franciscoarcos19/Proyecto_Protesis/README.md

# Proyecto_Protesis
Desarrollo de una prótesis para personas con amputación transhumeral o desarticulación de codo

Este es un proyecto financido por la Universidad Santiago de Cali, en el cual participan profesores y estudiantes de la misma Universidad
