franciscoarcos19/Proyecto_Protesis/Diseño_Mecánico/readme

En este directorio se encuentran los archivos STL de cada parte diseñada de la prótesis
