franciscoarcos19/Proyecto_Protesis/Control_Motores/readme

En este directorio se encuentra información y códigos realizados para el control de motores brushless
