franciscoarcos19/Proyecto_Protesis/Codigos_de_adquisicion/readme

En este directorio se encuentran los códigos con los cuales se adquirieon las señales, se trabajo con Arduino inicialmente incluido RTOS, pero finalmente el DataSet se construyo con una Beaglebone
