franciscoarcos19/Proyecto_Protesis/Compras/Solicitud_compras4/readme

Solicitud de compras de drivers de potencia para los motores BLDC y el motor del gripper
