franciscoarcos19/Proyecto_Protesis/Control_Motores/Control_de_Motores_BLDC/Informacion_JuanPabloAngulo_Canguro/link_videos.txt

Video 1:
https://www.youtube.com/watch?v=_aAwbQtJsLo&t=101s

Video 2:
https://www.youtube.com/watch?v=N1daKq9xIF4&t=0s

Video 3:
https://www.youtube.com/watch?v=YvfU8nAqAI8&t=0s

Video 4:
https://www.youtube.com/watch?v=TnECJG2mN-E&t=0s

Video 5:
https://www.youtube.com/watch?v=MKNkZOja7-s&t=0s

Video que recomienda acerca de motores eléctricos:
https://www.youtube.com/watch?v=I2_-etus0KQ&t=0s
