franciscoarcos19/Proyecto_Protesis/RealTime_MachineLearning/readme

DIrectorio donde se encuentran los archivos relacionados con la implementación de machine learning en tiempo real
