franciscoarcos19/Proyecto_Protesis/Articulo_Q2_2021/readme

Directorio en el cual se cargará la información para construir el artículo Q2 del 2021
