franciscoarcos19/Proyecto_Protesis/PagoEstudiantes/readme

Directorio en el cual se encuentra información relacionada con el pago de los estudiantes involucrados en el proyecto
