franciscoarcos19/Proyecto_Protesis/Compras/readme

En este directorio se encuentran las solicitudes de compra realizadas
