franciscoarcos19/Proyecto_Protesis/Machine_Learning/readme

En este directorio se encuentran los códigos para realizar la extracción de características, posteriormente se incluirán los códigos para realizar la clasificación
