franciscoarcos19/Proyecto_Protesis/DATA_SET_Myoelectric_Signals/readme

Directorio en el cual se encuentran las señales mioeléctricas de una persona con desarticulación de codo
