franciscoarcos19/Proyecto_Protesis/RealTime_MachineLearning/Solucion1/readme

En este directorio se encuentran los archivos para hacer la adquisición de datos y predicción del movimiento en tiempo real
