franciscoarcos19/Proyecto_Protesis/Codigos_de_adquisicion/Beaglebone/readme

Directorio en el que se encuentran los códigos para leer las señales con la Beaglebone
