franciscoarcos19/Proyecto_Protesis/DATA_SET_Myoelectric_Signals/Movimientos_Contraccion_Maxima/readme

En este directorio se encuentran los movimientos de contracción máxima
