franciscoarcos19/Proyecto_Protesis/Machine_Learning/Extraccion_Caracteristicas/Codes_PAC_v2/readme

Directorio que contiene los mismos archivos de la carpeta Codes_Pac, pero en este caso se guarda el clasificador y se utiliza posteriormente con datos singulares
