franciscoarcos19/Proyecto_Protesis/Machine_Learning/Extraccion_Caracteristicas/Codigos_Milton_Mejorados/readme

Actualización de los códigos realizados por el profe Milton, ya incluyen las características de William, las mias, y las de frecuencia
