franciscoarcos19/Proyecto_Protesis/Machine_Learning/Extraccion_Caracteristicas/Codes_Milton_William_F/readme

En este directorio se encuentran codigos combinados basados en las características de William, la automatizacion de Milton y mis códigos de visualización
