franciscoarcos19/Proyecto_Protesis/Machine_Learning/Extraccion_Caracteristicas/Caracteristicas_V2/readme

Directorio en el cual se encuentran las características extraidas, en el proceso anterior hubo un error, por esa razón se generó este directorio
