franciscoarcos19/Proyecto_Protesis/DATA_SET_Myoelectric_Signals/Data Set – Myoelectric Signals.pptx

## Data Set – Myoelectric Signals

## M1 – Flexión de Codo, Set 1

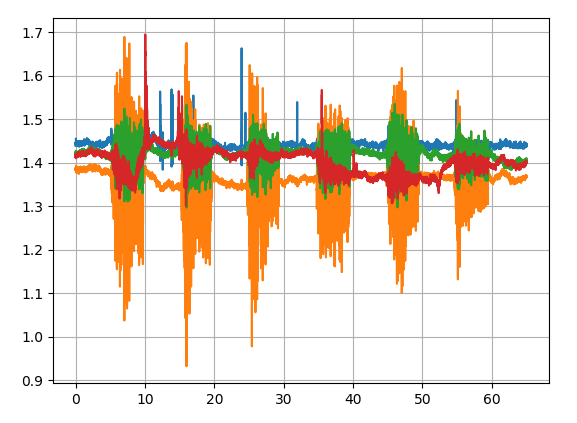
[picture p1: figure]

## M1 – Flexión de Codo, Set 2

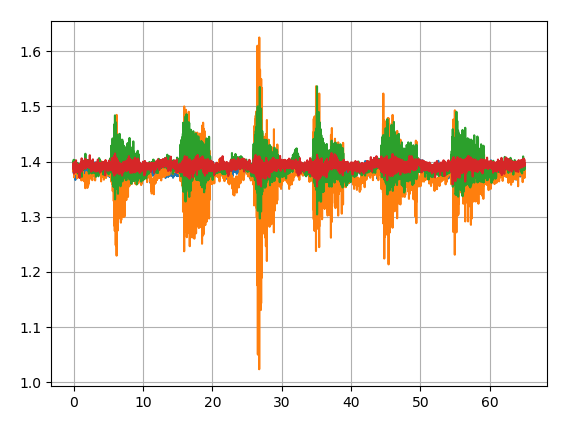
[picture p2: figure]

## M1 – Flexión de Codo, Set 3

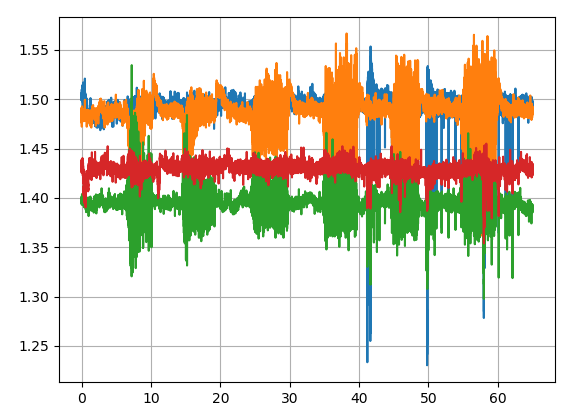
[picture p3: figure]

## M1 – Flexión de Codo, Set 4

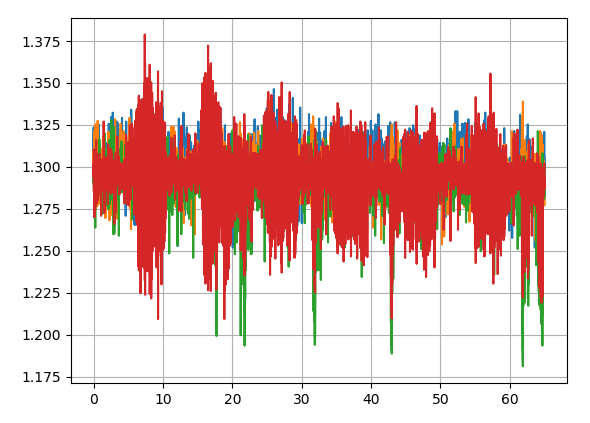
[picture p4: figure]

## M1 – Flexión de Codo, Set 5

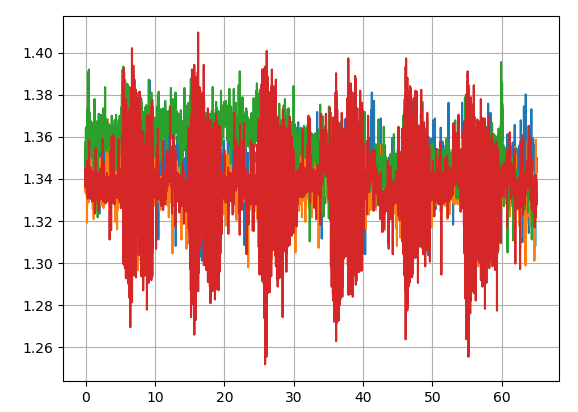
[picture p5: figure]

## M1 – Flexión de Codo, Set 6

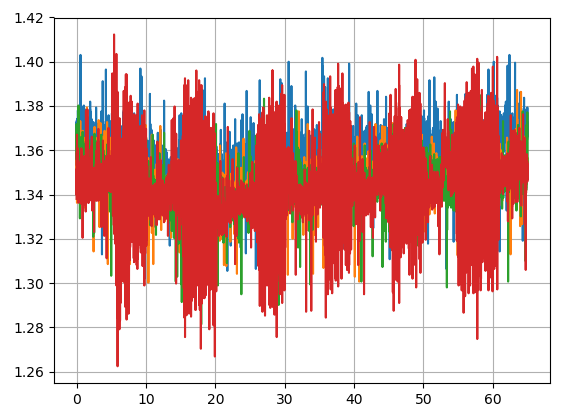
[picture p6: figure]
