franciscoarcos19/Proyecto_Protesis/Compras/Solicitud_Compras5/cotizacion_ferplast.docx

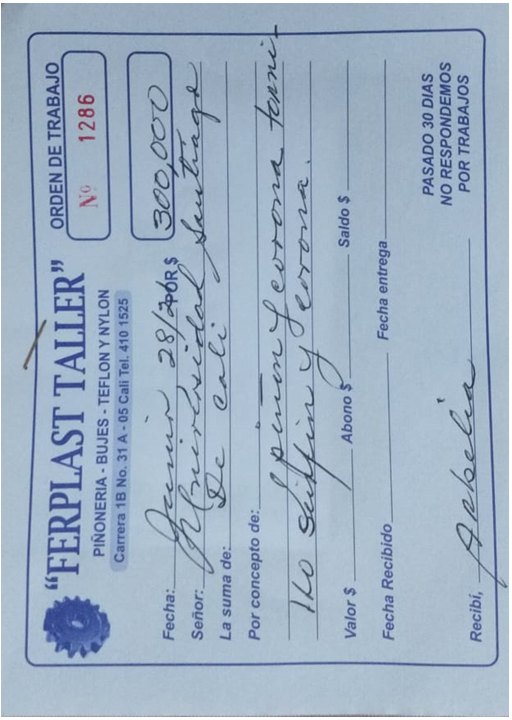
[picture p7: figure]
