franciscoarcos19/Proyecto_Protesis/Machine_Learning/Extraccion_Caracteristicas/senales_caracteristicas.pptx

Se usaron 4 sensores como el que se muestra en la figura, ubicados en el miembro residual de una persona con desarticulación de codo.
- S1-Deltoides
- S2-Biceps
- S3-Triceps
- S4-Tendón bíceps braquial
Se capturaron las señales emitidas por los sensores a una frecuencia de 1Khz cuando la persona realizaba diferentes movimientos. Los movimientos son:
- M1-Flexión de codo
- M2-Extensión de codo
- M3-Apertura de mano
- M4-Cierre de mano
- M5-Pronación de mano
- M6-Supinación de mano
- M7-Reposo

La ventana de datos para hacer la extracción de características es 100 datos, lo cual corresponde a 0.1 seg de señal

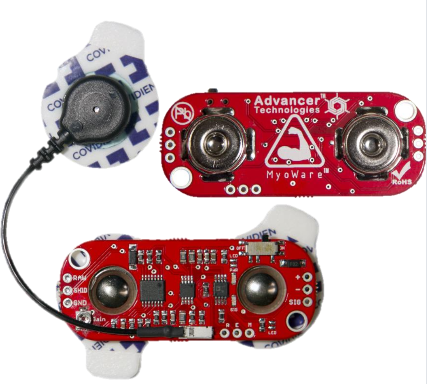
[picture p8: figure]

## GRÁFICAS PARA M1

## Slide 3

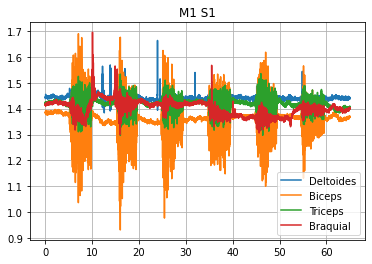
[picture p9: figure]
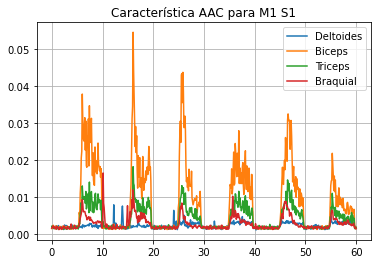
[picture p10: figure]
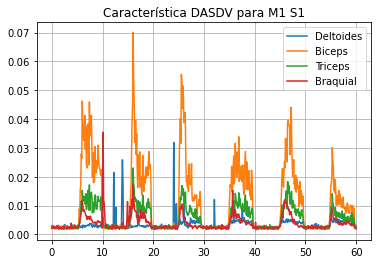
[picture p11: figure]
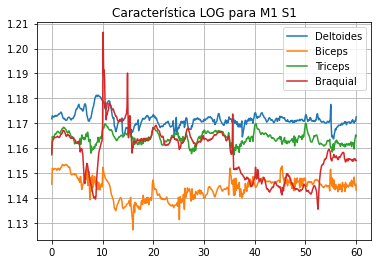
[picture p12: figure]
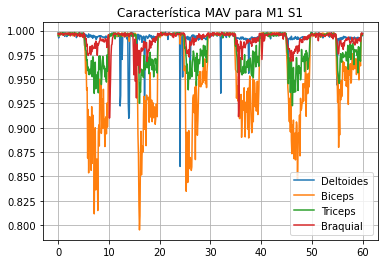
[picture p13: figure]
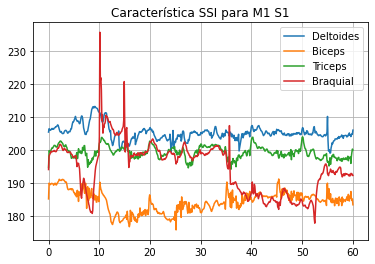
[picture p14: figure]
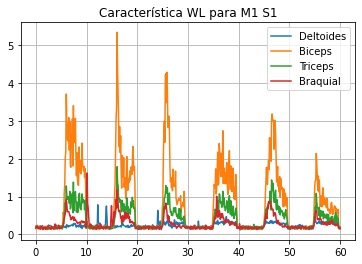
[picture p15: figure]
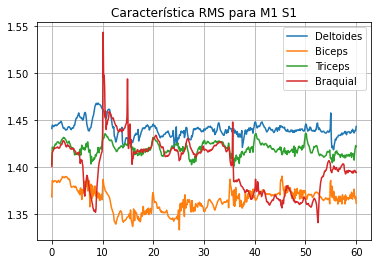
[picture p16: figure]

## Slide 4

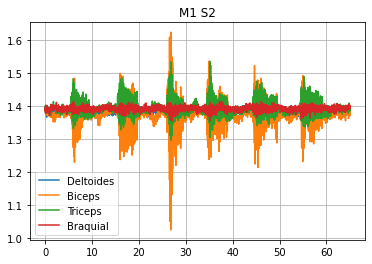
[picture p17: figure]
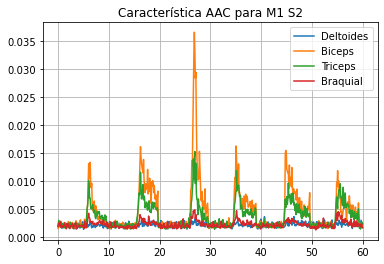
[picture p18: figure]
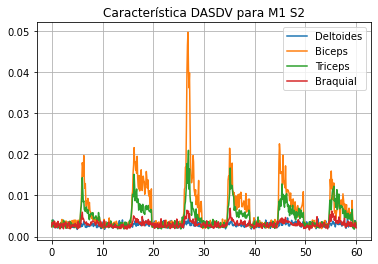
[picture p19: figure]
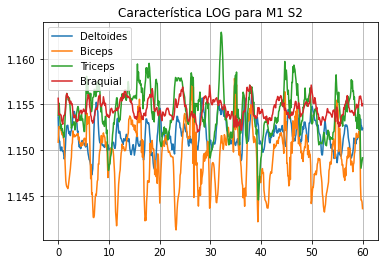
[picture p20: figure]
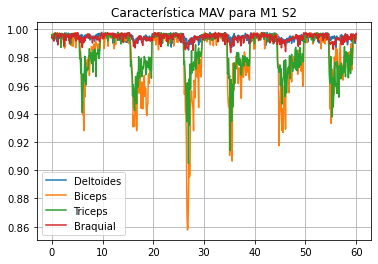
[picture p21: figure]
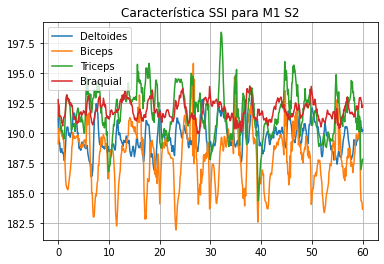
[picture p22: figure]
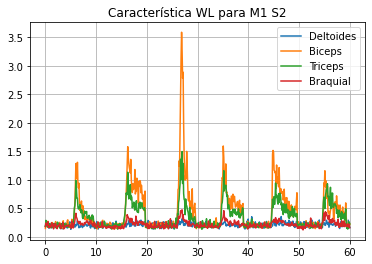
[picture p23: figure]
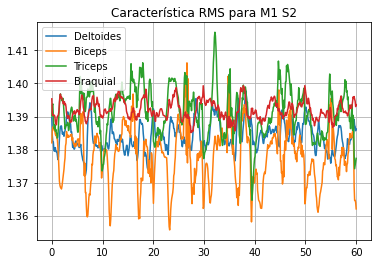
[picture p24: figure]

## Slide 5

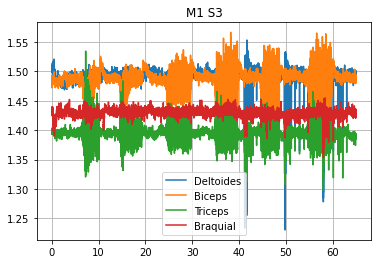
[picture p25: figure]
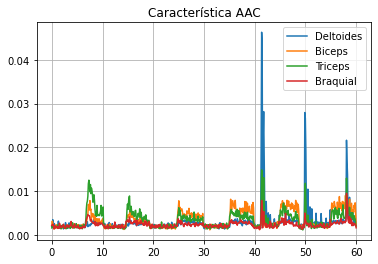
[picture p26: figure]
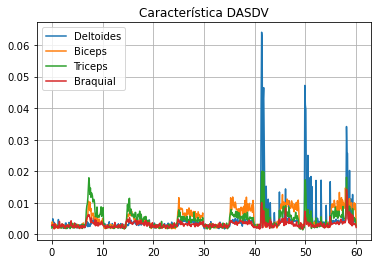
[picture p27: figure]
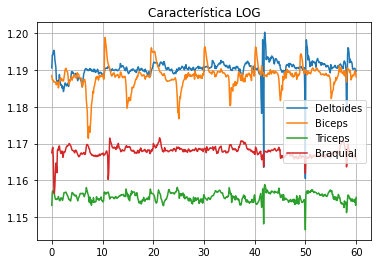
[picture p28: figure]
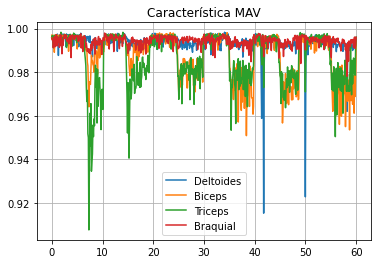
[picture p29: figure]
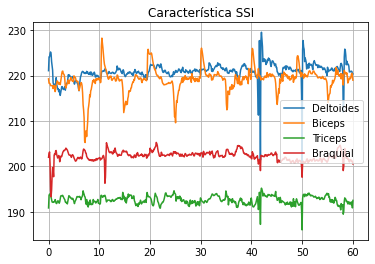
[picture p30: figure]
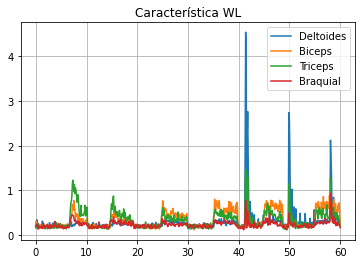
[picture p31: figure]
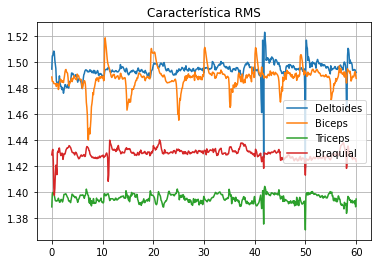
[picture p32: figure]

## Slide 6

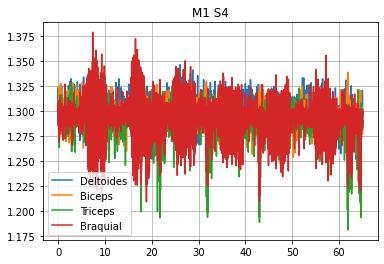
[picture p33: figure]
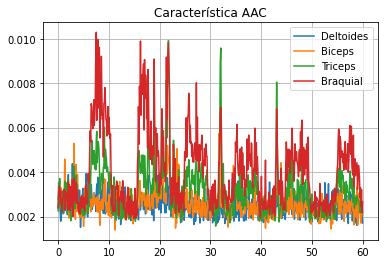
[picture p34: figure]
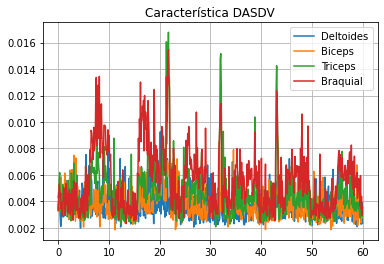
[picture p35: figure]
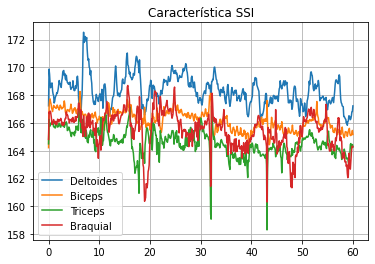
[picture p36: figure]
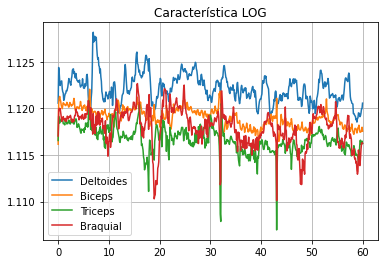
[picture p37: figure]
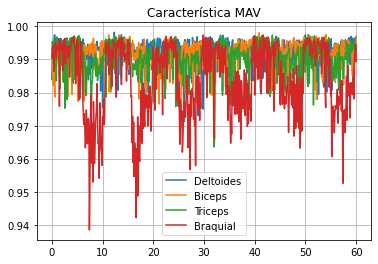
[picture p38: figure]
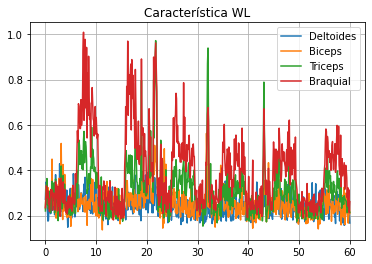
[picture p39: figure]
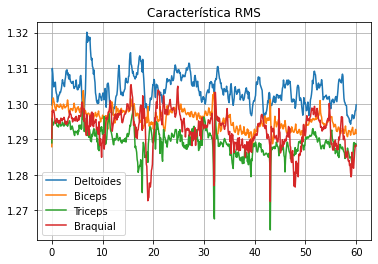
[picture p40: figure]

## Slide 7

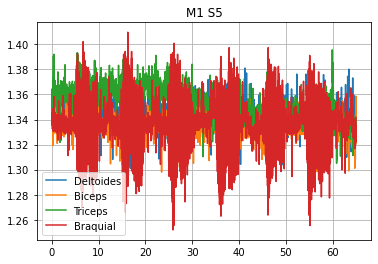
[picture p41: figure]
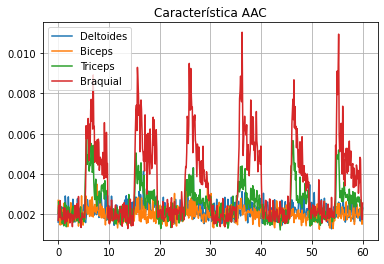
[picture p42: figure]
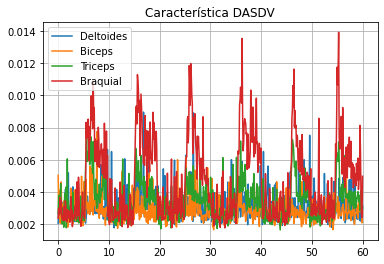
[picture p43: figure]
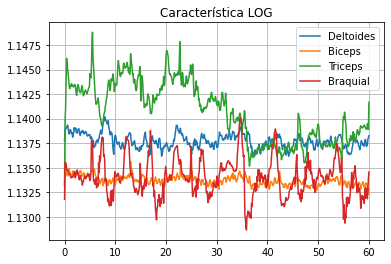
[picture p44: figure]
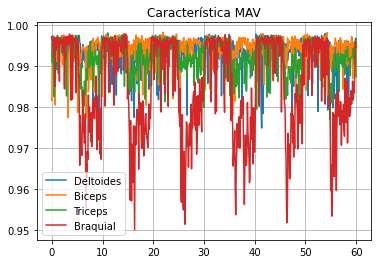
[picture p45: figure]
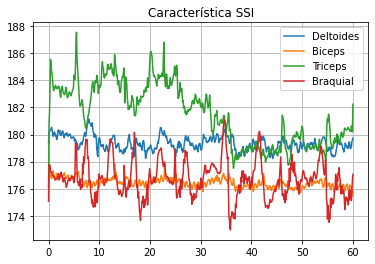
[picture p46: figure]
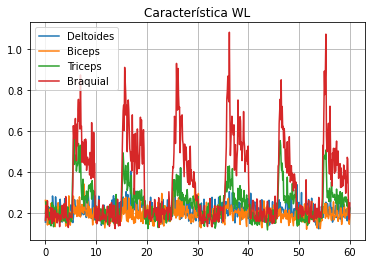
[picture p47: figure]
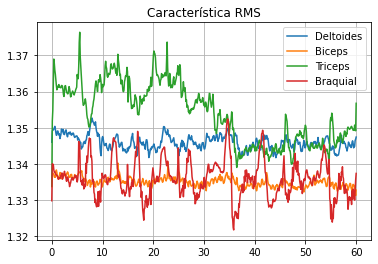
[picture p48: figure]

## Slide 8

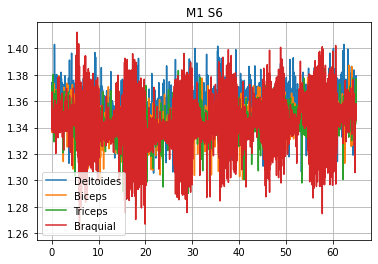
[picture p49: figure]
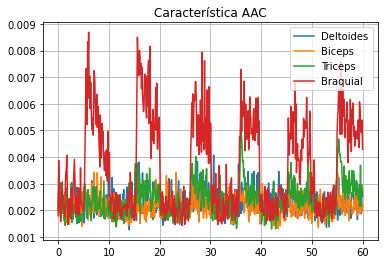
[picture p50: figure]
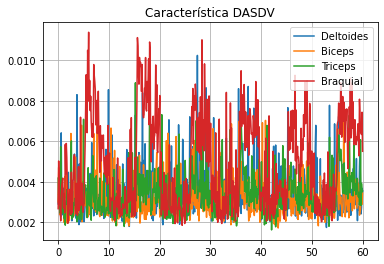
[picture p51: figure]
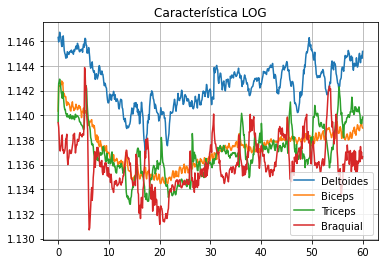
[picture p52: figure]
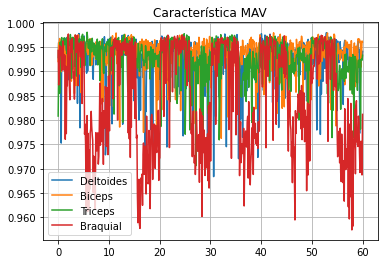
[picture p53: figure]
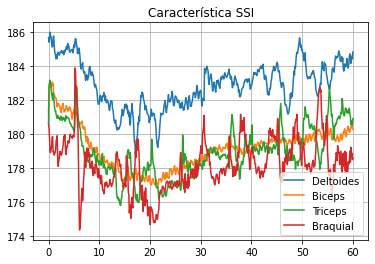
[picture p54: figure]
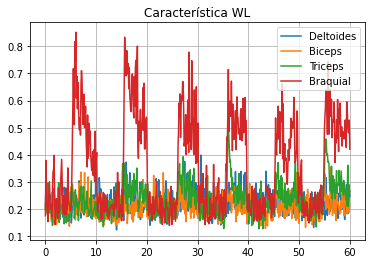
[picture p55: figure]
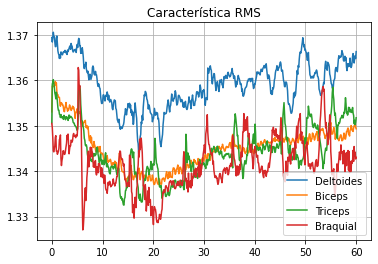
[picture p56: figure]

## GRÁFICAS PARA M2

## Slide 10

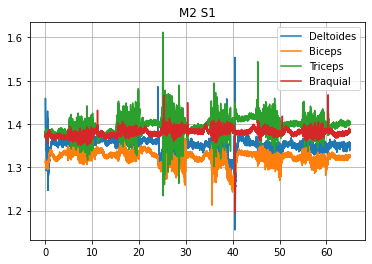
[picture p57: figure]
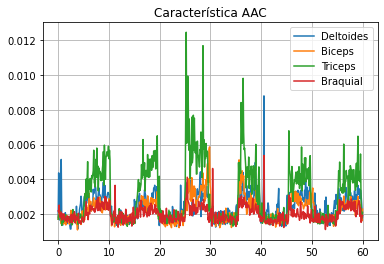
[picture p58: figure]
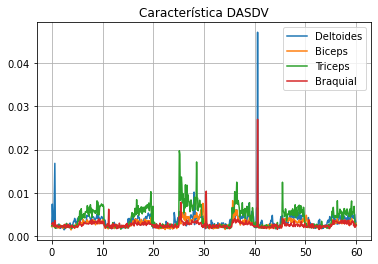
[picture p59: figure]
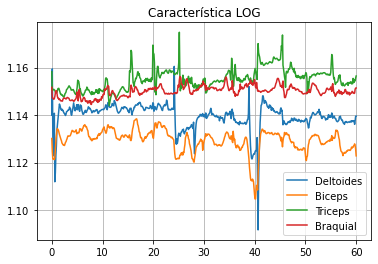
[picture p60: figure]
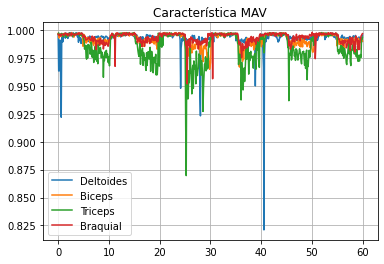
[picture p61: figure]
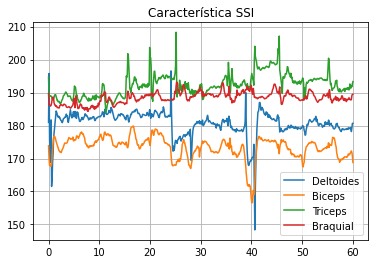
[picture p62: figure]
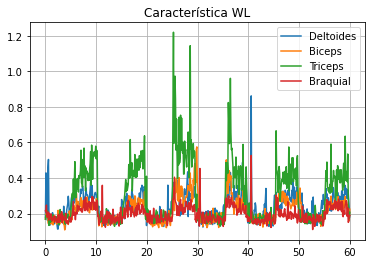
[picture p63: figure]
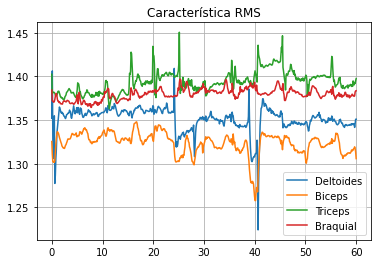
[picture p64: figure]

## Slide 11

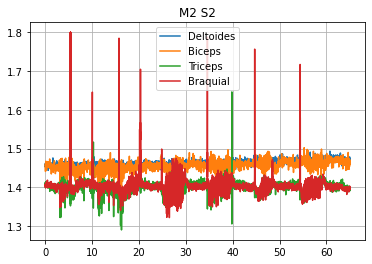
[picture p65: figure]
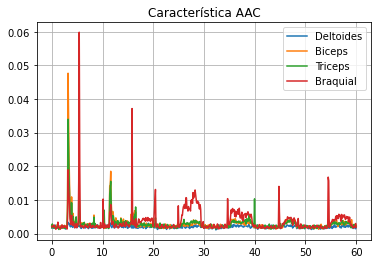
[picture p66: figure]
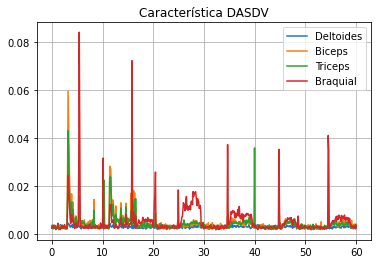
[picture p67: figure]
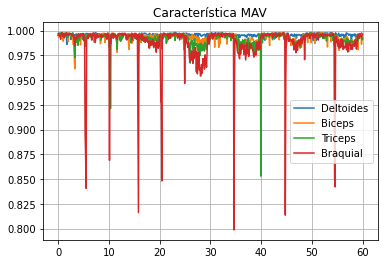
[picture p68: figure]
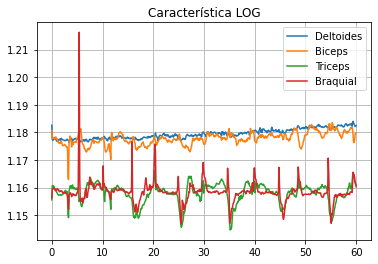
[picture p69: figure]
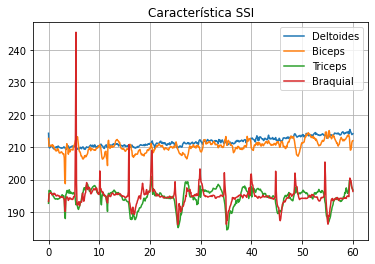
[picture p70: figure]
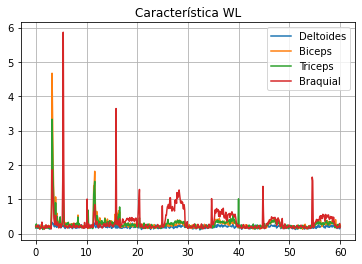
[picture p71: figure]
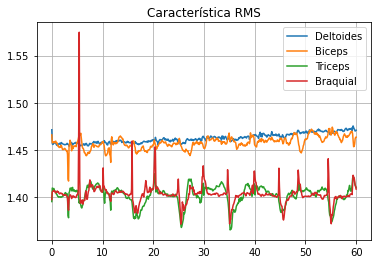
[picture p72: figure]

## Slide 12

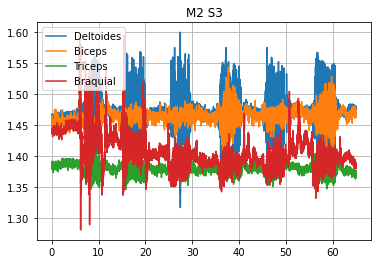
[picture p73: figure]
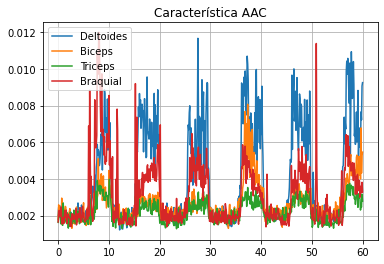
[picture p74: figure]
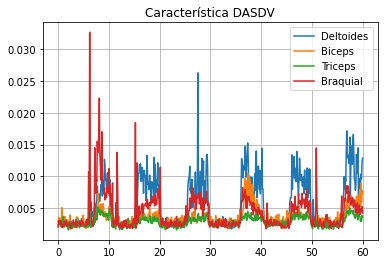
[picture p75: figure]
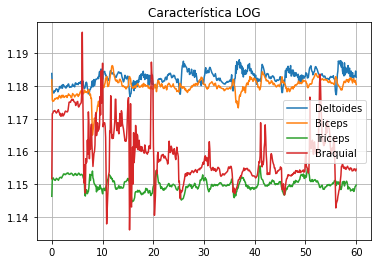
[picture p76: figure]
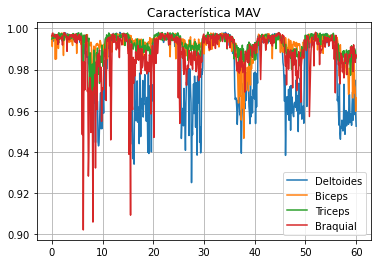
[picture p77: figure]
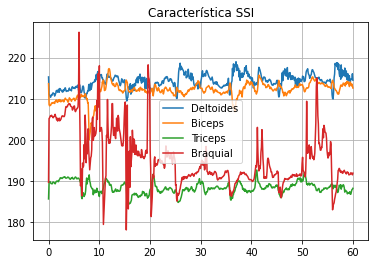
[picture p78: figure]
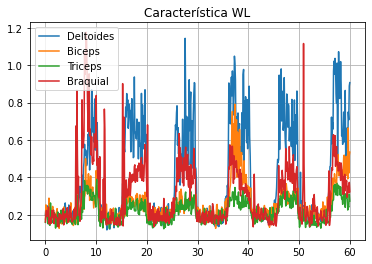
[picture p79: figure]
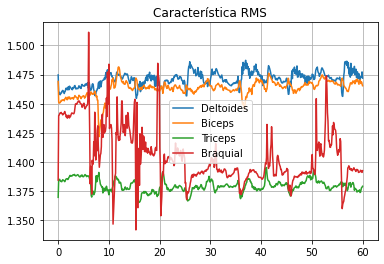
[picture p80: figure]

## Slide 13

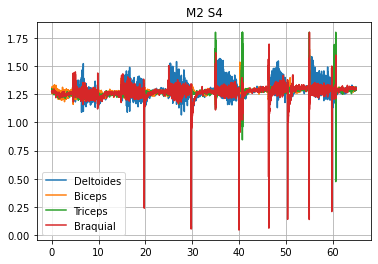
[picture p81: figure]
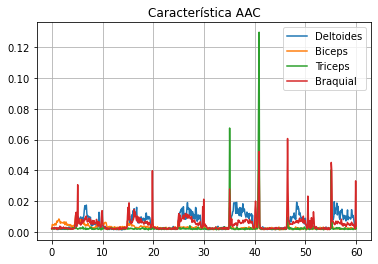
[picture p82: figure]
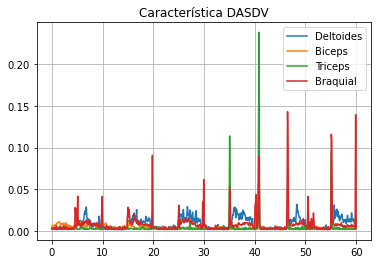
[picture p83: figure]
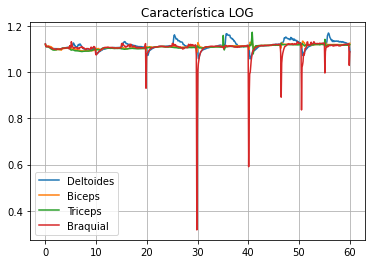
[picture p84: figure]
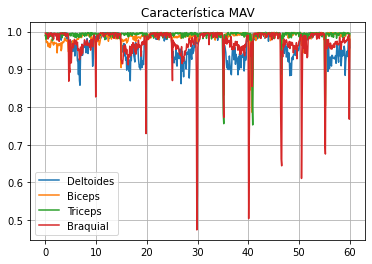
[picture p85: figure]
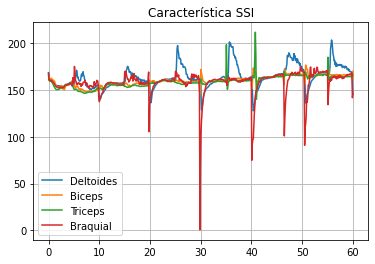
[picture p86: figure]
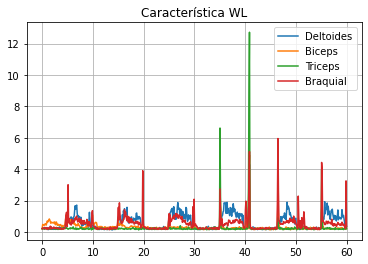
[picture p87: figure]
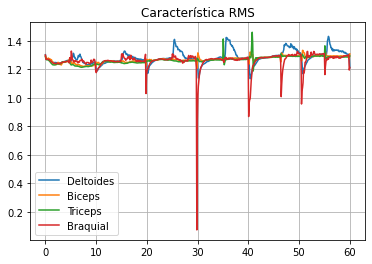
[picture p88: figure]

## Slide 14

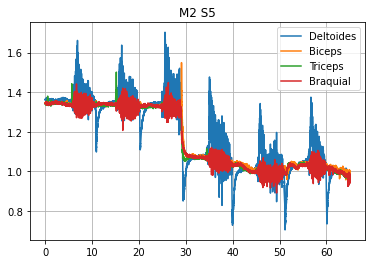
[picture p89: figure]
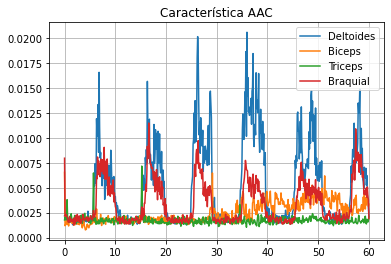
[picture p90: figure]
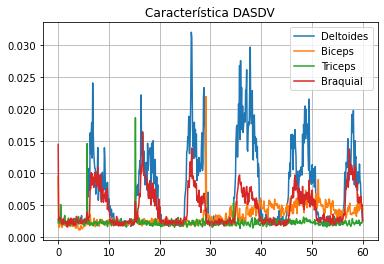
[picture p91: figure]
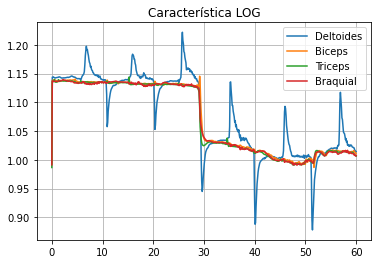
[picture p92: figure]
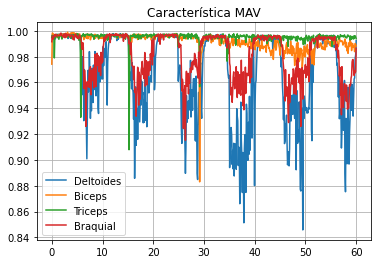
[picture p93: figure]
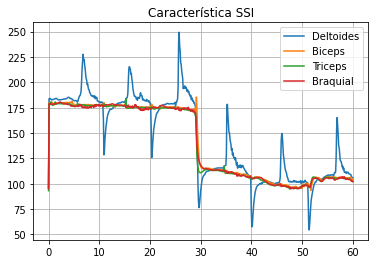
[picture p94: figure]
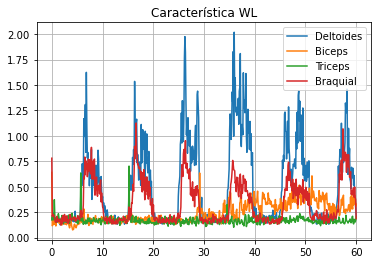
[picture p95: figure]
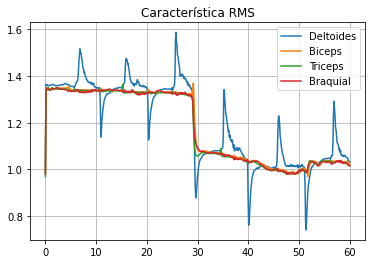
[picture p96: figure]

## Slide 15

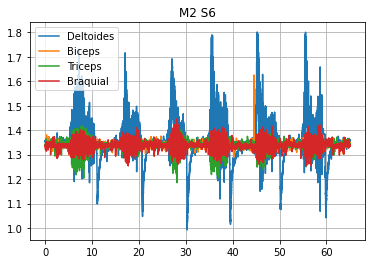
[picture p97: figure]
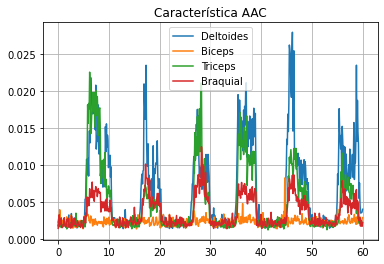
[picture p98: figure]
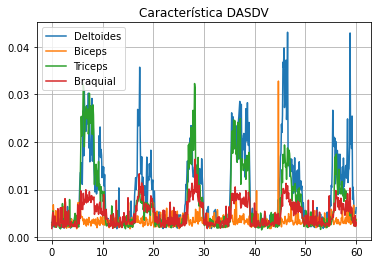
[picture p99: figure]
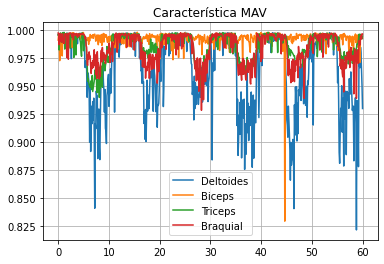
[picture p100: figure]
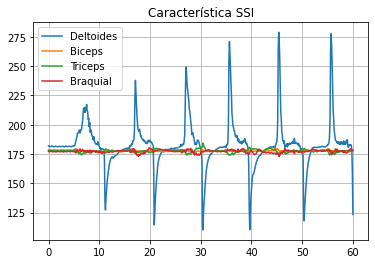
[picture p101: figure]
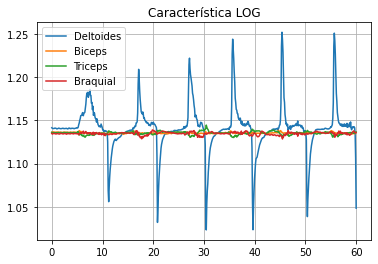
[picture p102: figure]
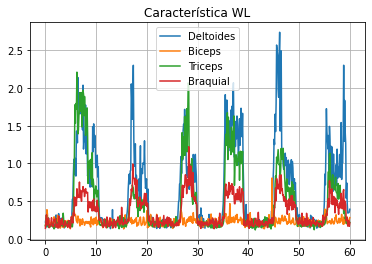
[picture p103: figure]
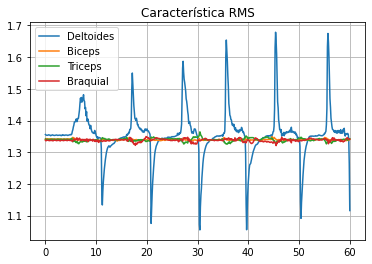
[picture p104: figure]

## Slide 16

## Slide 17
