franciscoarcos19/Proyecto_Protesis/informacion_general/acta_inicio.pdf

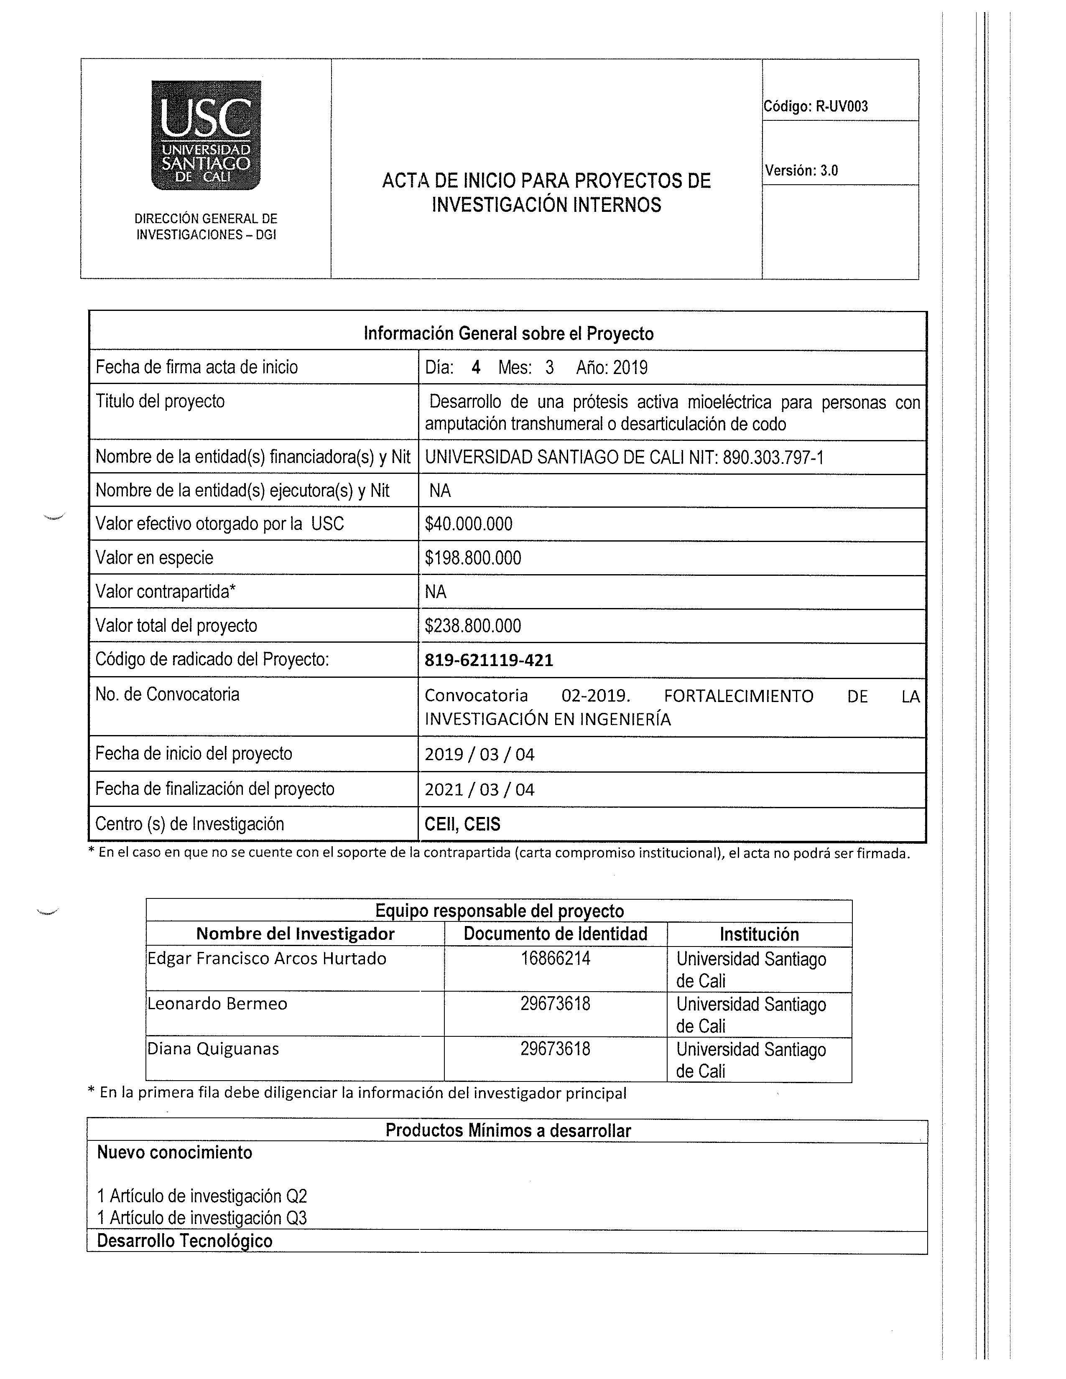
[picture p105: page 1]
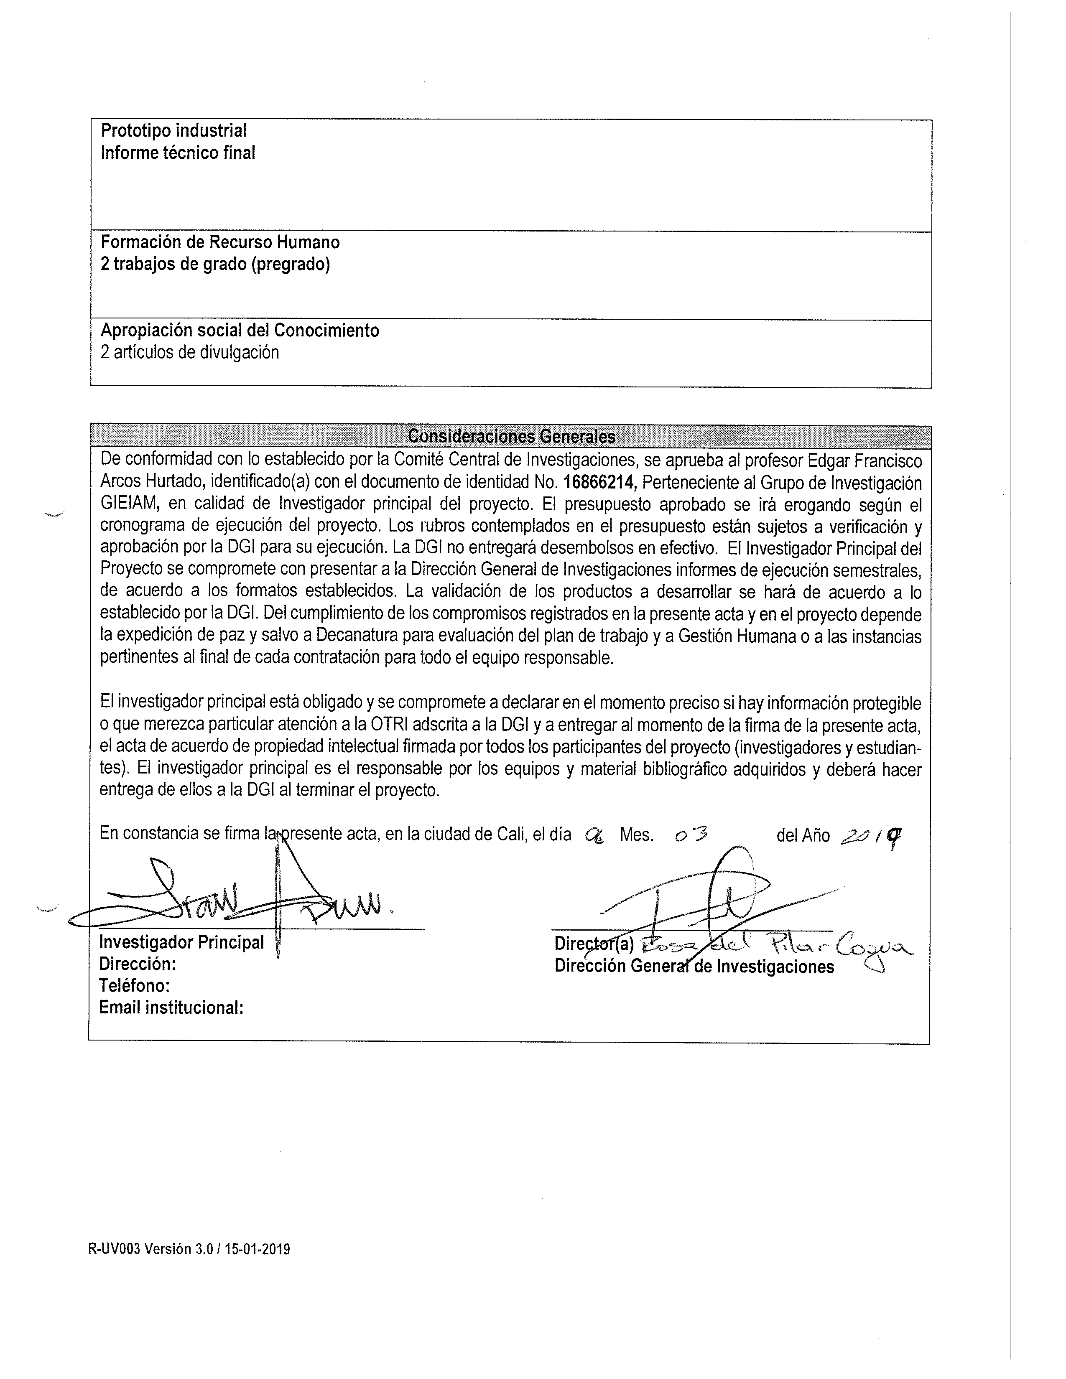
[picture p106: page 2]
