franciscoarcos19/Proyecto_Protesis/informacion_general/PRORROGA.pdf

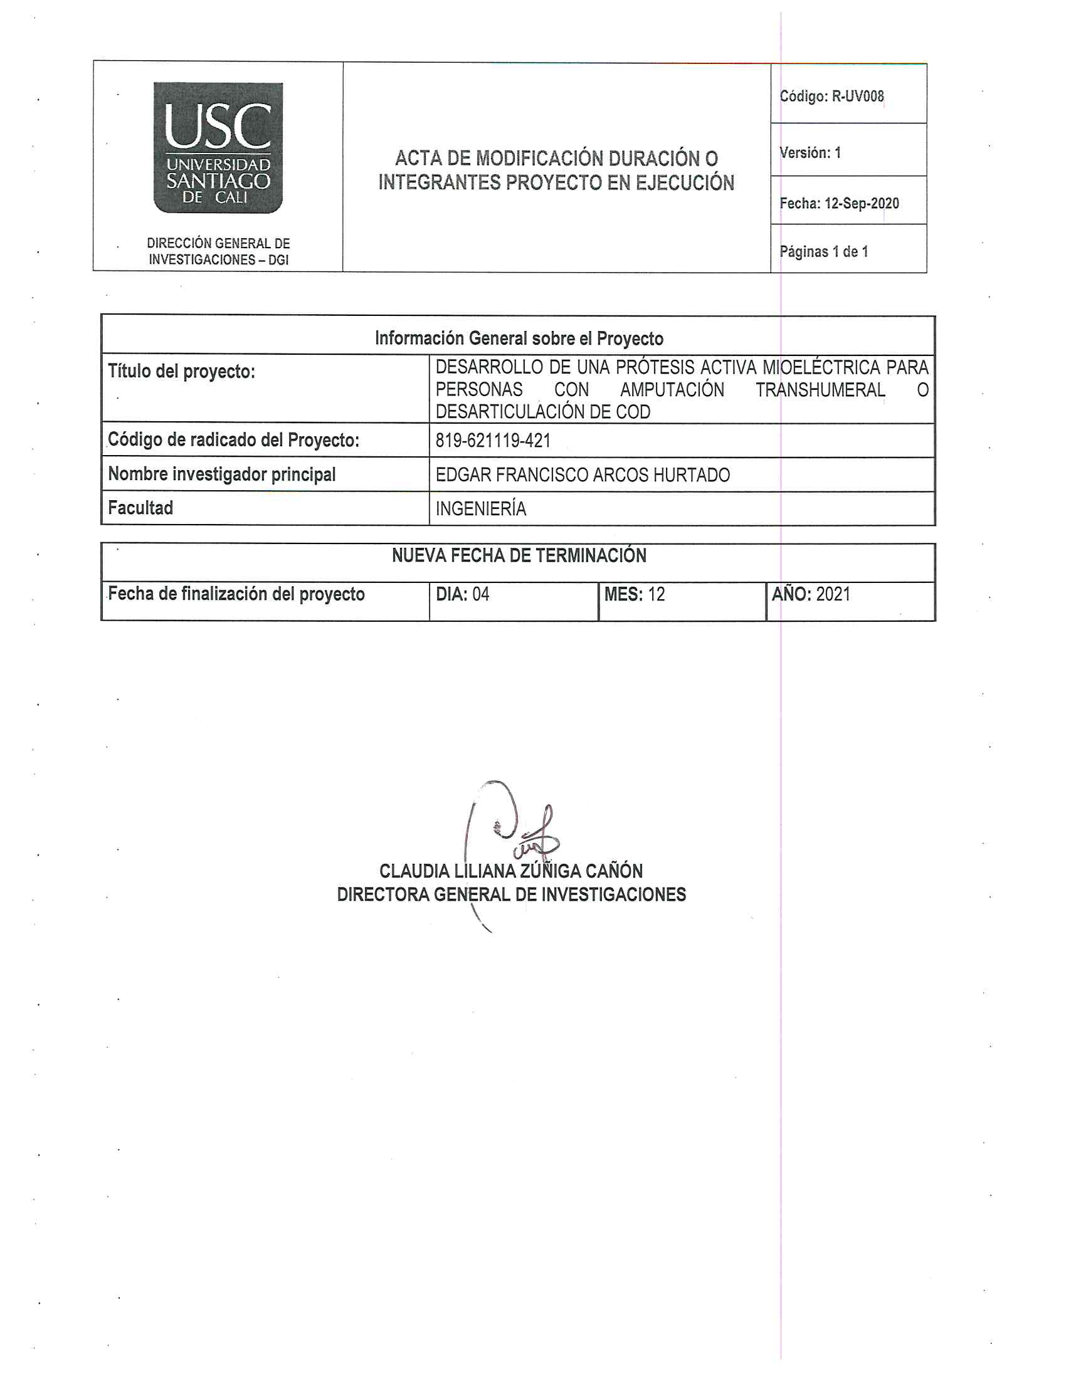
[picture p107: page 1]
