franciscoarcos19/Proyecto_Protesis/Compras/Solicitud_Compras5/Plano corona.pdf

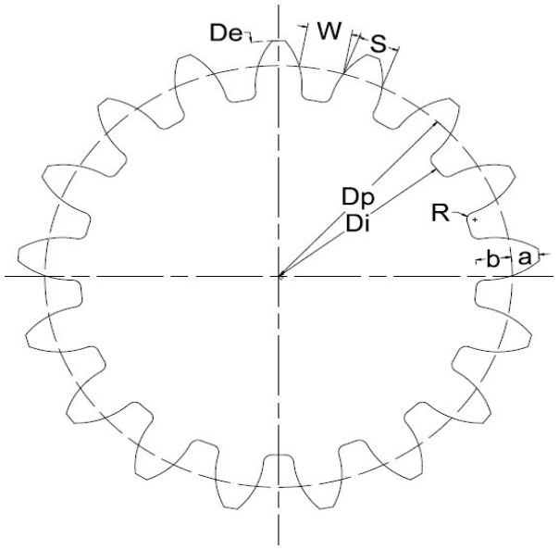
[picture p109: figure]

Parametro | Formula | Piñon | Corona
Dientes (Z) | | 8,0 | 17,0
Diametro exterior (De) | Dp+2*M | 10,0 | 19,0
Diametro primitivo (Dp o d) | Z*M | 8,0 | 17,0
Diametro interior (Di)
hueco del diente (W) | Pc*21/40 = π*M21/40 | 1,6 | 1,6
Espesor del diente (S) | Pc*19/40 | 1,5 | 1,5
radio de entalle (r) | Pc/12 = π*M/12 | 0,3 | 0,3
altura de cabeza (a) | M | 1,0 | 1,0
altura del pie del diente (b) | 1.25*M | 1,3 | 1,3
Dientes (Z)
Modulo (M) | De/z+2 | 1,0
Paso circular (Pc) o (P) | π*M o S+W | 3,1
Angulo de presion | | 20,0
Angulo entre dientes | | 45,0 | 21,2
distancia entre centro (DC) | (Dp+dp)/2 | 12,5

Plano corona

Juego de piñon - corona
