franciscoarcos19/Proyecto_Protesis/Machine_Learning/Extraccion_Caracteristicas/Codes_PAC/readme

En este directorio se encuentran los códigos para implementar la clasificación utilizando PAC y características de frecuencia nuevas
