franciscoarcos19/Proyecto_Protesis/Codigos_de_adquisicion/Beaglebone/Captura_4C_1Khz_beaglebone.PNG

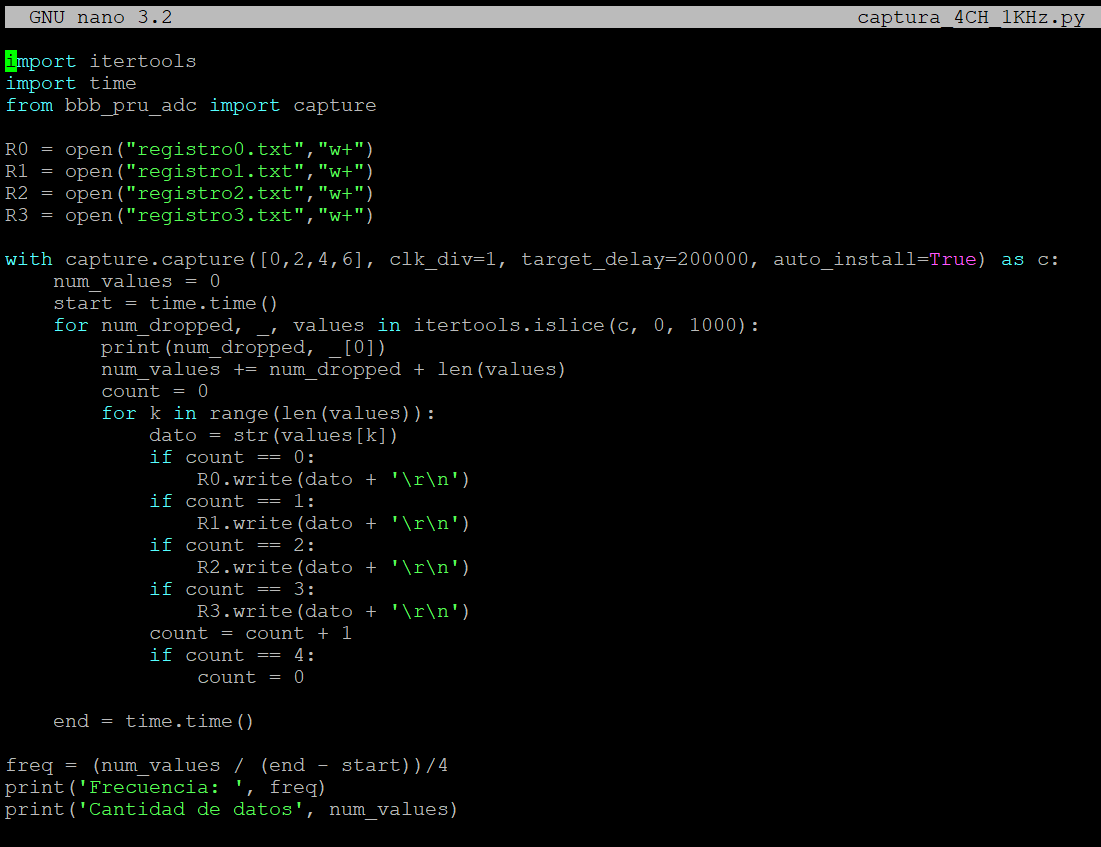
Codigos_de_adquisicion/Beaglebone/Captura_4C_1Khz_beaglebone.PNG
