franciscoarcos19/Proyecto_Protesis/Codigos_de_adquisicion/Beaglebone/captura_datos_beaglebone.PNG

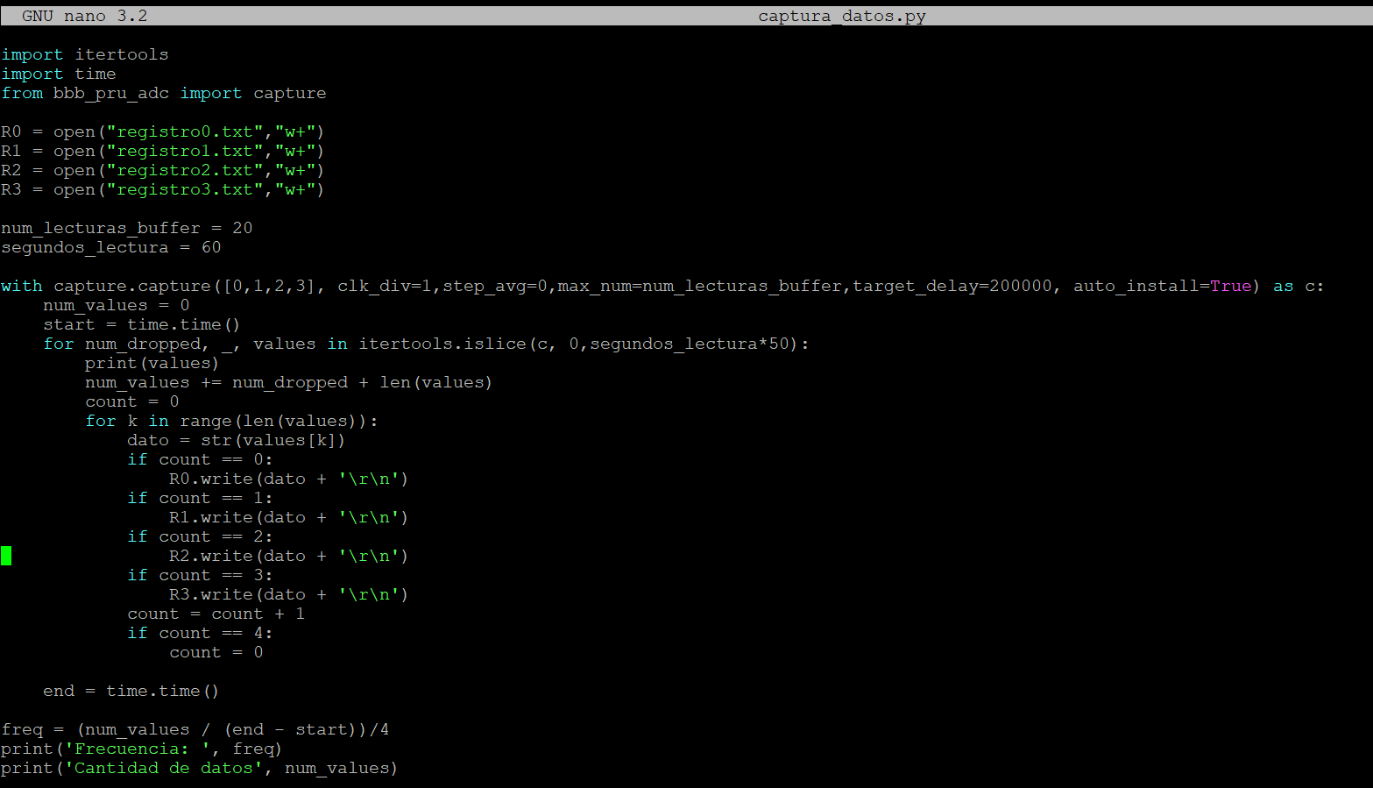
Codigos_de_adquisicion/Beaglebone/captura_datos_beaglebone.PNG
