franciscoarcos19/Proyecto_Protesis/Control_Motores/Control_de_Motores_BLDC/Especificaciones_motores_propios/especificaciones_EC-max.PNG

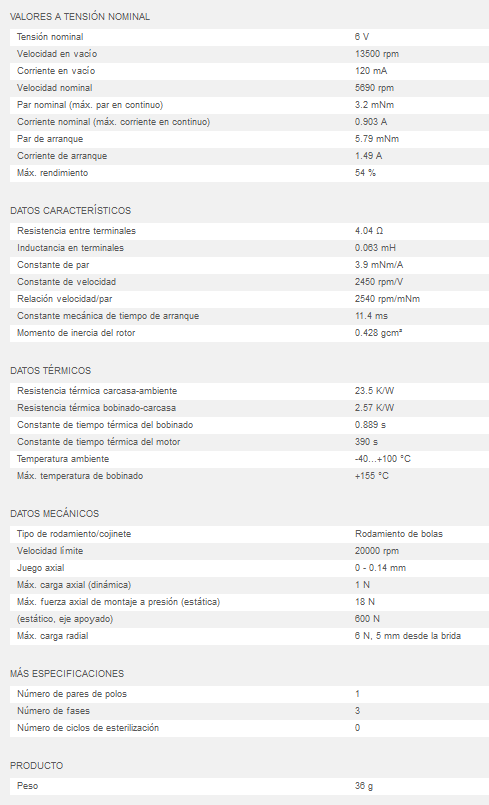
Control_Motores/Control_de_Motores_BLDC/Especificaciones_motores_propios/especificaciones_EC-max.PNG
