franciscoarcos19/Proyecto_Protesis/Control_Motores/Control_de_Motores_BLDC/Especificaciones_motores_propios/especificaciones_flat60.PNG

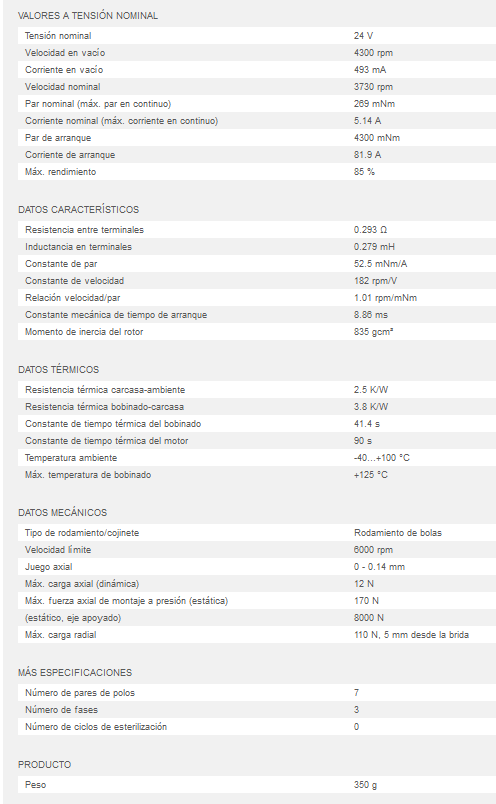
Control_Motores/Control_de_Motores_BLDC/Especificaciones_motores_propios/especificaciones_flat60.PNG
