franciscoarcos19/Proyecto_Protesis/Control_Motores/Control_de_Motores_BLDC/Materiales a comprar.xlsx

Elemento | Cantidad | Valor unitario | Valor | Fuente
Controlador + Sensor | 2 | 15 | 30 | https://www.amazon.com/ICQUANZX-Gimbal-Controller-Current-Brushless/dp/B081CSQCYX
Controlador | 2 | 15 | 30 | https://simplefoc.com/shop
Controlador | 1 | 44 | 44 | https://www.ebay.com/itm/124316900944
Controlador | 1 | 136 | 136 | https://odriverobotics.com/shop/odrive-v36
Developer kit | 1 | 174 | 174 | https://mjbots.com/collections/servos-and-controllers/products/moteus-r4-5-developer-kit
Motor + Encoder | 2 | 53 | 106 | https://shop.iflight-rc.com/index.php?route=product/product&product_id=243
 |  |  | 520
