franciscoarcos19/Proyecto_Protesis/Compras/Solicitud_compras4/solicitud_compras_drivers_motorgripper.xlsx

UNIVERSIDAD SANTIAGO DE CALI
FORMATO DE SOLICITUD DE COMPRA DE BIENES Y/O SERVICIOS
FECHA: |  | 2021-06-25
NOMBRE DEL SOLICITANTE: |  | Edgar Francisco Arcos Hurtado |  | TELEFONO: 3104456374
DEPENDENCIA: |  | Dirección General de Investigaciones |  | CONSECUTIVO INTERNO DEPENDENCIA
JEFE DEPENDENCIA: |  | Claudia Liliana Zuñiga Cañon
LINEA ESTRATEGICA: |  | Investigación e innovación para la excelencia | CENTRO DE COSTO: | 6211
E-MAIL RESPONSABLE ELABORACIÓN CDIS: |  | proyectos.dgi@usc.edu.co | SITIO / BODEGA: | NA
JUSTIFICACION DE LA SOLICITUD: |  | Solicitud de componentes para el proyecto de investigación denominado "Desarrollo de una prótesis activa mioeléctrica para personas con amputación transhumeral o desarticulación de codo" con radicado No 819-621119-421
No. | DETALLE DEL BIEN Y/O SERVICIO | ESPECIFICACIONES | MARCA | UNIDAD DE MEDIDA | CANTIDAD | REF. INTERNA / OBSERVACIÓN
1 | Tarjeta electrónica | DRV8302 | Genérico | Unidad | 1 | Motor driver module
2 | Tarjeta electrónica | BLDC-SHIELD_IFX007T | Infineon Technologies | Unidad | 1 | Motor driver module
3 | Tarjeta electrónica | Moteus r4.5 | MJBOTS | Unidad | 1 | Motor driver module
4 | Motor DC sin escobillas | Motor EC-max 16 Ø16 mm, Conmutaciónelectrónica (Brushless), 5 Vatios, consensores Hall | MAXON | Unidad | 1 | 283826
5
6
7 | Reductor para motor DC sin escobillas | Reductor Planetario GP 16 A Ø16 mm,0,1 - 0,3 Nm, versión en metal, cojinetesinteriza | MAXON | Unidad | 1 | 110323
8
9
10 | Sensor para motor DC sin escobillas | Sensor - Encoder MR Tipo M, 512 ppv, 2 canales,con line drive | MAXON | Unidad | 1 | 201937
11
12
13
14
15
FIRMA Y SELLO JEFE DEPENDENCIA |  | FIRMA Y SELLO RESPONSABLE EJECUCIÓN | FIRMA Y SELLO AVAL
 |  | Firma Reponsable Gestión Tecnológica (Equipos tecnología, comunicación, software, Cableado de datos y voz) | Encargado de Vicerrectoria Administrativa: Bienes y/o Servicios Servicios Generales
 |  |  | Coordinación de Cultura - alquiler de sonido para eventos institucionales
 |  | Firma Responsable Servicios Generales | Dirección Unidad Comunicación: Material Publicitario con Imagen Institucional
VISTO BUENO TRAMITE DE COMPRA ORDENADOR DEL GASTO |  | Firma Director Técnico (Laboratorio de Metrología) | Vicerrector Academico - Adquisicion de Material Bibliografico |  | ASIGNACION SC / FECHA, FIRMA Y SELLO COMPRAS Y SUMINISTROS
 |  |  |  | R-SM001 / Versión 10 / 2 de febrero de 2021
