franciscoarcos19/Proyecto_Protesis/Compras/solicitud_compras1/solicitud_compras1.xlsx

UNIVERSIDAD SANTIAGO DE CALI
FORMATO DE SOLICITUD DE COMPRA DE BIENES Y/O SERVICIOS
FECHA: |  | 30 de septiembre de 2019
NOMBRE DEL SOLICITANTE: |  | Edgar Francisco Arcos Hurtado |  | TELEFONO: 3104456374
DEPENDENCIA: |  | Dirección General de Investigaciones |  | CONSECUTIVO INTERNO DEPENDENCIA
JEFE DEPENDENCIA: |  | Rosa del Pilar Cogua Romero
CENTRO DE COSTO: |  | 6211
E-MAIL RESPONSABLE ELABORACIÓN CDIS: |  | proyectos.dgi@usc.edu.co
JUSTIFICACION DE LA SOLICITUD: |  | Solicitud de componentes para el proyecto de investigación denominado "Desarrollo de una prótesis activa mioeléctrica para personas con amputación transhumeral o desarticulación de codo" con radicado No 819-621119-421
No. | DETALLE DEL BIEN Y/O SERVICIO | ESPECIFICACIONES | MARCA | UNIDAD DE MEDIDA | CANTIDAD | REF. INTERNA / OBSERVACIÓN
1 | Sensor mioeléctrico | MyoWare Muscle Sensor | ADVANCER ELECTRONICS | Unidad | 4 | AT-04-001
2 | Cable shield | Myoware Cable Shield |  | Unidad | 4 | DEV-13687
3 | Electrodos superficiales | MyoWare Electrodes (50-pack) | COVIDIEN | Unidad | 1 | AT-03-004
4 | Motor DC sin escobillas | Motor Maxon EC 60 flat Ø60 mm, brushless, 100 W, with Hall sensors | MAXON | Unidad | 1 | 625855
5 | Motor DC sin escobillas | Motor Maxon EC-max 16 O16 mm, Conmutación electrónica (Brushless), 5 Vatios, con sensores Hall | MAXON | Unidad | 1 | 283826
6 | Reductor para motor Maxon EC-max 16 O16mm | Reductor planetario GP 16 A Ø16 mm, 0,1 - 0,3 Nm, versión en metal, cojinete sinterizado | MAXON | Unidad | 1 | 118185
7 | Sistema embebido | Beaglebone black | BEAGLEBONE | Unidad | 1 | NA
8 | Sistema embebido | Arduino nano | ARDUINO | Unidad | 2 | NA
9 | Encoder absoluto magnético | Austria Microsystems AS5145 absolute magnetic encoder | AUSTRIA MICROSYSTEM | Unidad | 2 | AS5145
FIRMA Y SELLO JEFE DEPENDENCIA |  | FIRMA Y SELLO RESPONSABLE EJECUCIÓN | FIRMA Y SELLO AVAL
 |  | Firma Coordinadores Gestión Tecnológica (Cableado de datos y voz - Telefonía) | Coordinación Gestión Tecnológica: Equipos tecnología y comunicación - software - voz y datos - telefonía
 |  |  | Coordinación de Cultura - alquiler de sonido para eventos institucionales
 |  | Firma responsable Servicios Generales | Dirección Unidad Comunicación: Material Publicitario con Imagen Institucional
VISTO BUENO TRAMITE DE COMPRA ORDENADOR DEL GASTO |  | Firma Director Técnico (Laboratorio de Metrología) | Coordinación Servicios Generales: Materiales de Mantenimiento |  | ASIGNACION SC / FECHA, FIRMA Y SELLO COMPRAS Y SUMINISTROS
 |  |  |  | R-SM001 / Versión 9 / 26 de Septiembre de 2018
