franciscoarcos19/Proyecto_Protesis/informacion_general/Presupuesto_entregado.xlsx

Sheet: Presupuesto
 |  | FORMATO DE PRESENTACIÓN DE PRESUPUESTO CONVOCATORIAS PARA PROYECTOS DE INVESTIGACIÓN |  |  |  |  |  | Código: R-UV005
 |  |  |  |  |  |  |  | Versión: 2.0
DIRECCIÓN GENERAL DE INVESTIGACIONES – DGI |  |  |  |  |  |  |  | Páginas
Nombre del proyecto: |  |  |  | Nombre del Docente |  |  |  | Sin Validar | Sin Validar
Tabla 1. Presupuesto Global del Proyecto
ITEM | RUBROS |  |  | RECURSOS |  |  | TOTAL
 |  |  |  | USC |  | Contrapartida (Terceros)
 |  |  |  | Efectivo | Especie
1 | PERSONAL DEL PROYECTO (Tabla 2) |  |  | $6000000 | $48800000 | $0 | $54800000
 | SERVICIOS TÉCNICOS (Tabla 3) |  |  | $0 | $0 | $0 | $0
2 | ARRENDAMIENTO DE EQUIPOS (Tabla 4) |  |  | $0 | $0 | $0 | $0
3 | AFILIACIONES (Tabla 5) |  |  | $4000000 | $0 | $0 | $4000000
4 | SEGUROS (Tabla 6) |  |  | $0 | $0 | $0 | $0
5 | SERVICIOS (Tabla 7) |  |  | $5000000 | $0 | $0 | $5000000
6 | MANTENIMIENTO Y ADECUACIONES (Tabla 8) |  |  | $0 | $0 | $0 | $0
7 | VIAJES (Tabla 9) Máximo cuatro millones |  |  |  | $0 | $0 | $0
8 | SALIDAS DE CAMPO (Tabla 10) |  |  |  | $0 | $0 | $0
9 | DIVERSOS "MATERIALES BIBLIOGRÁFICOS, PUBLICACIONES , INSUMOS" (Tabla 11) |  |  |  | $0 | $0 | $0
10 | EQUIPOS Y SOFTWARE (Tabla 12) |  |  | $25000000 | $150000000 | $0 | $175000000
 |  |  | TOTAL | $40000000 | $198800000 | $0 | $238800000
Tabla 2 Descripción de los gastos de Personal (equipo de investigadores)
RUBRO | CONCEPTO | NOMBRE DEL INVESTIGADOR | FORMACIÓN ACADÉMICA | FUNCIÓN DENTRO DEL PROYECTO | HORAS DE DEDICACIÓN MES | RECURSOS |  |  | TOTAL
 |  |  |  |  |  | USC |  | Contrapartida (Terceros)
 |  |  |  |  |  | Especie
511010 | HONORARIOS EN ESPECIE | Edgar Francisco Arcos Hurtado | Msc | Investigador | 8 | $24000000 |  |  | $24000000
 |  | Leonardo Bermeo | PhD | Co-Investigador | 4 | $12400000 |  |  | $12400000
 |  | Diana Quiguanas | PhD, fisioterapeuta | Co-Investigador | 4 | $12400000 |  |  | $12400000
 |  |  |  |  |  |  |  |  | $0
 |  |  |  |  |  |  |  |  | $0
 |  |  |  |  | TOTAL | $48800000 |  | $0 | $48800000
Tabla 3 Descripción de los gastos por Servicios Técnicos (Personal calificado o especializado)
RUBRO | CONCEPTO | NOMBRE DEL EXPERTO | FORMACIÓN ACADÉMICA | FUNCIÓN DENTRO DEL PROYECTO | HORAS DE DEDICACIÓN MES | RECURSOS |  |  | TOTAL
 |  |  |  |  |  | USC |  | Contrapartida (Terceros)
 |  |  |  |  |  | Efectivo | Especie
511010 | Trabajos Especiales |  |  |  |  |  |  |  | $0
 |  |  |  |  |  |  |  |  | $0
 |  |  |  |  |  |  |  |  | $0
 |  |  |  |  |  |  |  |  | $0
 |  |  |  |  |  |  |  |  | $0
 |  |  |  |  | TOTAL | $0 | $0 | $0 | $0
Tabla No. 4 Descripción de los Bienes en Arrendamientos
RUBRO | CONCEPTO | EQUIPO | JUSTIFICACIÓN |  |  | RECURSOS |  |  | TOTAL
 |  |  |  |  |  | USC |  | Contrapartida (Terceros)
 |  |  |  |  |  | Efectivo | Especie
512006 | Bienes Muebles (Equipos oficina) |  |  |  |  |  |  |  | $0
512010 | Otros Arrendamientos (Maquinaria y Equipos, Stands, Sonido y Flota) |  |  |  |  |  |  |  | $0
 |  |  |  |  | TOTAL | $0 | $0 | $0 | $0
Tabla No. 5 Descripción de gastos en Afiliaciones
RUBRO | CONCEPTO | JUSTIFICACIÓN |  |  |  | RECURSOS |  |  | TOTAL
 |  |  |  |  |  | USC |  | Contrapartida (Terceros)
 |  |  |  |  |  | Efectivo | Especie
512505 | Afiliaciones (redes, congresos, pago en revistas) | Inscripción a Congresos |  |  |  | $4000000 |  |  | $4000000
 |  |  |  |  |  |  |  |  | $0
 |  |  |  |  |  |  |  |  | $0
 |  |  |  |  |  |  |  |  | $0
 |  |  |  |  | TOTAL | $4000000 | $0 | $0 | $4000000
Tabla No. 6 Descripción de gastos en Seguros
RUBRO | CONCEPTO | JUSTIFICACIÓN |  |  |  | RECURSOS |  |  | TOTAL
 |  |  |  |  |  | USC |  | Contrapartida (Terceros)
 |  |  |  |  |  | Efectivo | Especie
513007 | De Cumplimiento |  |  |  |  |  |  |  | $0
513007 | Otros Seguros |  |  |  |  |  |  |  | $0
 |  |  |  |  | TOTAL | $0 | $0 | $0 | $0
Tabla No. 7 Descripción de gastos en Servicios
RUBRO | CONCEPTO | JUSTIFICACIÓN |  |  |  | RECURSOS |  |  | TOTAL
 |  |  |  |  |  | USC |  | Contrapartida (Terceros)
 |  |  |  |  |  | Efectivo | Especie
513510 | Correo y Portes |  |  |  |  |  |  |  | $0
513511 | Transporte, Fletes y Acarreos |  |  |  |  |  |  |  | $0
513513 | Propaganda y Publicidad |  |  |  |  |  |  |  | $0
513512 | Otros Servicios (Personal no especializado) |  |  |  |  |  |  |  | $0
 |  |  |  |  | TOTAL | $0 | $0 | $0 | $0
Tabla No. 8 Descripción de gastos en Mantenimientos y Adecuaciones
RUBRO | CONCEPTO | JUSTIFICACIÓN |  |  |  | RECURSOS |  |  | TOTAL
 |  |  |  |  |  | USC |  | Contrapartida (Terceros)
 |  |  |  |  |  | Efectivo | Especie
514506 | Bienes Muebles (Equipos oficina) |  |  |  |  |  |  |  | $0
514507 | Equipos de Computo |  |  |  |  |  |  |  | $0
514507 | Equipo Medio Científico |  |  |  |  |  |  |  | $0
 |  |  |  |  | TOTAL | $0 | $0 | $0 | $0
Tabla No. 9 Descripción y justificación Gastos de Viaje
RUBRO | CONCEPTO | LUGAR / No. de viajes | JUSTIFICACIÓN |  | TOTAL DÍAS | RECURSOS |  |  | TOTAL
 |  |  |  |  |  | USC |  | Contrapartida (Terceros)
 |  |  |  |  |  | Efectivo | Especie
515506 | Pasajes Aéreos |  |  |  |  |  |  |  | $0
 |  |  |  |  |  |  |  |  | $0
515508 | Transporte Terrestre (fuera de la ciudad) |  |  |  |  |  |  |  | $0
 |  |  |  |  |  |  |  |  | $0
515505 | Viáticos (Tarifa Autorizada) |  |  |  |  |  |  |  | $0
 |  |  |  |  |  |  |  |  | $0
515505 | Alojamiento (Viajes Nacionales) |  |  |  |  |  |  |  | $0
 |  |  |  |  |  |  |  |  | $0
 |  |  |  |  | TOTAL | $0 | $0 | $0 | $0
Tabla No. 10 Descripción y justificación Gastos Salida de Campo
RUBRO | CONCEPTO | LUGAR / No. de viajes | JUSTIFICACIÓN |  | TOTAL DÍAS | RECURSOS |  |  | TOTAL
 |  |  |  |  |  | USC |  | Contrapartida (Terceros)
 |  |  |  |  |  | Efectivo | Especie
515505 | Viáticos (Tarifa Autorizada) |  |  |  |  |  |  |  | $0
 |  |  |  |  |  |  |  |  | $0
515508 | Transporte Terrestre (fuera de la ciudad) |  |  |  |  |  |  |  | $0
 |  |  |  |  |  |  |  |  | $0
515506 | Pasajes Aéreos |  |  |  |  |  |  |  | $0
 |  |  |  |  |  |  |  |  | $0
515507 | Alojamiento (Viajes Nacionales) |  |  |  |  |  |  |  | $0
 |  |  |  |  |  |  |  |  | $0
 |  |  |  |  | TOTAL | $0 | $0 | $0 | $0
Tabla No. 11 Diversos "Materiales Bibliográficos, Publicaciones, insumos, suministros y bibliografía"
RUBRO | CONCEPTO | JUSTIFICACIÓN |  | COSTO UNITARIO | CANT. | RECURSOS |  |  | TOTAL
 |  |  |  |  |  | USC |  | Contrapartida (Terceros)
 |  |  |  |  |  | Efectivo | Especie
519505 | Útiles y Papelería |  |  |  |  |  |  |  | $0
519506 | Fotocopias |  |  |  |  |  |  |  | $0
519507 | Elementos de Aseo para laboratorio |  |  |  |  |  |  |  | $0
519508 | Insumos de Laboratorio |  |  |  |  |  |  |  | $0
519509 | Insumos Médicos |  |  |  |  |  |  |  | $0
519510 | Material Didáctico |  |  |  |  |  |  |  | $0
519512 | Refrigerios |  |  |  |  |  |  |  | $0
519515 | Adquisicion de libros |  |  |  |  |  |  |  | $0
519515 | Combustibles |  |  |  |  |  |  |  | $0
519515 | Actividades Cívicas y Culturales |  |  |  |  |  |  |  | $0
519515 | Auxilio Estudiantes | Vinculación estudiantes (2) como auxiliares de Investigación |  |  | 2 | $6000000 |  |  | $6000000
 |  |  |  |  | TOTAL | $6000000 | $0 | $0 | $6000000
Tabla No. 12 Descripción de los equipos y software que se planea adquirir
CONCEPTO |  | EQUIPO | JUSTIFICACIÓN |  |  | RECURSOS |  |  | TOTAL
 |  |  |  |  |  | USC |  | Contrapartida (Terceros)
 |  |  |  |  |  | Efectivo | Especie
Inversiones |  | Impresoras 3D, sccanner, CMD | Contruccion del prototipo |  |  |  | $150000000 |  | $150000000
 |  | Sensores EMG | Sistema Hardware Software para registro de señales |  |  | $10000000 |  |  | $10000000
 |  | Placas para desarrollo de sistemas de control | Sistema Hardaware Software para registro de señales |  |  | $4500000 |  |  | $4500000
 |  | materiales para prototipo industrial | Diseño e implementacion de prototipo |  |  | $500000 |  |  | $500000
 |  | Motores eléctricos | Sistema de actuación |  |  | $10000000 |  |  | $10000000
 |  |  |  |  | TOTAL | $25000000 | $150000000 | $0 | $175000000

Sheet: Instructivo
I. INSTRUCTIVO DE DILIGENCIAMIENTO DEL FORMATO
1. DEFINICIONES:
1.1. Efectivo: Es el dinero que se solicita a la DGI para la convocatoria que se esta presentando.
1.2. Especie: Estos rubros corresponden a sueldos docentes de la USC y recursos físicos, de infraestructura y funcionamiento de la Institución que se usaran en el desarrollo del proyecto. (Ver nota a)
1.3. Contrapartida: La contrapartida puede ser en especie o efectivo aportado por una empresa o institución externa, por lo cual se debe adjuntar carta donde se acepta el compromiso y se manifiesta
conocimiento de los términos de la convocatoria.
1.4. Consecutivo: Código asignado por el DGI una vez recibido el presupuesto para trazabilidad y seguimiento (No diligenciar)
2. PROCEDIMIENTO
2.1. Todos los valores suministrados deben ser en pesos colombianos m/cte no se aceptan conversiones a miles o ninguna otra forma de conversión.
2.2. En la tabla 1 (Presupuesto global del proyecto) se consolida toda la información suministrada por el responsable de la investigación, conforme a la información suministrada el formato recomienda
2.3. Solo se permite la modificación de las tablas 2 a la tabla 12, allí se deben incluir todos los rubros necesarios para la ejecución del proyecto de investigación según corresponda.
2.4. Se pueden incluir nuevas filas en las tablas mencionadas en el punto anterior en caso de requerirse mayor detalle en uno de los rubros especificados.
2.6. Tabla 3 (Servicios Técnicos). Todo concepto por honorarios a profesionales que desarrollarán una actividad especializada o técnica necesaria para el cumplimiento de los objetivos del proyecto.
El pago de estos honorarios esta sujeto al cumplimiento de las politicas establecidas por la Gerencia Financiera de la Universidad.
No se financiará este rubro para personas con algún tipo de contratación con la Universidad
2.7. Tabla 9 (Descripción y justificación gastos de viajes) Se refiere a viajes relacionados con actividades del proyecto diferentes de salidas de campo y que son estrictamente requeridos para la ejecución
exitosa del proyecto (por ejemplo, visitas a otros centros de investigación para capacitación, traer asesores para el proyecto o participación en actividades de socialización de resultados de la
investigación (se podrá presupuestar transporte, alojamiento y viaticos). Por este rubro solo se financiará hasta el cuatro millones de pesos mtce
2.8. Tabla 11 (Materiales Bibliográficos, insumos, suministros y bibliografía) Corresponden a aquellos necesarios para el desarrollo de la investigación o de la tecnología y deben presentarse a
manera de listado detallado agrupado por categorías sobre las cuales se debe hacer una justificación de su necesidad y uso dentro del proyecto. Se podrá financiar bibliografía debidamente justificada
y directamente relacionada con la temática del proyecto en la forma de libros y/o suscripciones a revistas científicas del tema.
2.9. Tabla 12 (Equipos y Software): La financiación para compra de equipos nuevos deberá estar sustentada en la estricta necesidad de los mismos para el desarrollo de la investigación. Es importante
que los investigadores verifiquen si el equipo que necesitan ya existe en otra dependencia de la USC o en otra institución, de la cual pudiese solicitarse en préstamo o arrendamiento. Todas las inversiones estan sujetas a aprobación por el ordenador del gasto.
II. NOTAS
a) Los valores en especie no serán concepto de desembolso pues hacen parte de la infraestructura de la USC.
b) El monto total del presupuesto solicitado a la DGI de la universidad USC no debe exceder lo establecido en los Términos de Referencia de la convocatoria a la que presento el proyecto.
c) El formulario solo será recibido según este formato, esta prohibido cualquier intento de modificación a sus formulas de validación y estará sujeto a posterior revisión.
d) Se recuerda que todos los valores deben ser en pesos colombianos m/cte no se aceptarán valores incluidos en miles o cualquier otro tipo de conversión.
