franciscoarcos19/Proyecto_Protesis/Compras/solicitud_compras2/solicitud_compras2.xlsx

UNIVERSIDAD SANTIAGO DE CALI
FORMATO DE SOLICITUD DE COMPRA DE BIENES Y/O SERVICIOS
FECHA: |  | 28 de febrerode 2020
NOMBRE DEL SOLICITANTE: |  | Edgar Francisco Arcos Hurtado |  | TELEFONO: 3104456374
DEPENDENCIA: |  | Dirección General de Investigaciones |  | CONSECUTIVO INTERNO DEPENDENCIA
JEFE DEPENDENCIA: |  | Rosa del Pilar Cogua Romero
CENTRO DE COSTO: |  | 6211
E-MAIL RESPONSABLE ELABORACIÓN CDIS: |  | proyectos.dgi@usc.edu.co
JUSTIFICACION DE LA SOLICITUD: |  | Solicitud de componentes para el proyecto de investigación denominado "Desarrollo de una prótesis activa mioeléctrica para personas con amputación transhumeral o desarticulación de codo" con radicado No 819-621119-421
No. | DETALLE DEL BIEN Y/O SERVICIO | ESPECIFICACIONES | MARCA | UNIDAD DE MEDIDA | CANTIDAD | REF. INTERNA / OBSERVACIÓN
1 | Piñon sencillo | Piñon sencillo paso 1/4", manzana tipo B, Z = 9 dientes | ZSG | Unidad | 5 | 25B09
2 | Piñon sencillo | Piñon sencillo paso 1/4", manzana tipo B, Z = 25 dientes | ZSG | Unidad | 3 | 25B25
3 | Cadena sencilla | Cadena sencilla paso 1/4" 3.05 m | PCC JP | Caja | 1 | RC25-1RP
4 | Union de cierre | Union de cierre paso 1/4" | PCC JP | unidad | 5 | CL25-1
5 | Rodamiento | Rodamiento (8MMx16MMx5MM) | FAG | unidad | 10 | 608-2RS
9
FIRMA Y SELLO JEFE DEPENDENCIA |  | FIRMA Y SELLO RESPONSABLE EJECUCIÓN | FIRMA Y SELLO AVAL
 |  | Firma Coordinadores Gestión Tecnológica (Cableado de datos y voz - Telefonía) | Coordinación Gestión Tecnológica: Equipos tecnología y comunicación - software - voz y datos - telefonía
 |  |  | Coordinación de Cultura - alquiler de sonido para eventos institucionales
 |  | Firma responsable Servicios Generales | Dirección Unidad Comunicación: Material Publicitario con Imagen Institucional
VISTO BUENO TRAMITE DE COMPRA ORDENADOR DEL GASTO |  | Firma Director Técnico (Laboratorio de Metrología) | Coordinación Servicios Generales: Materiales de Mantenimiento |  | ASIGNACION SC / FECHA, FIRMA Y SELLO COMPRAS Y SUMINISTROS
 |  |  |  | R-SM001 / Versión 9 / 26 de Septiembre de 2018
