franciscoarcos19/Proyecto_Protesis/Diseño_Mecánico/Archivos_STL/Antebrazo/platina motor 2.stl

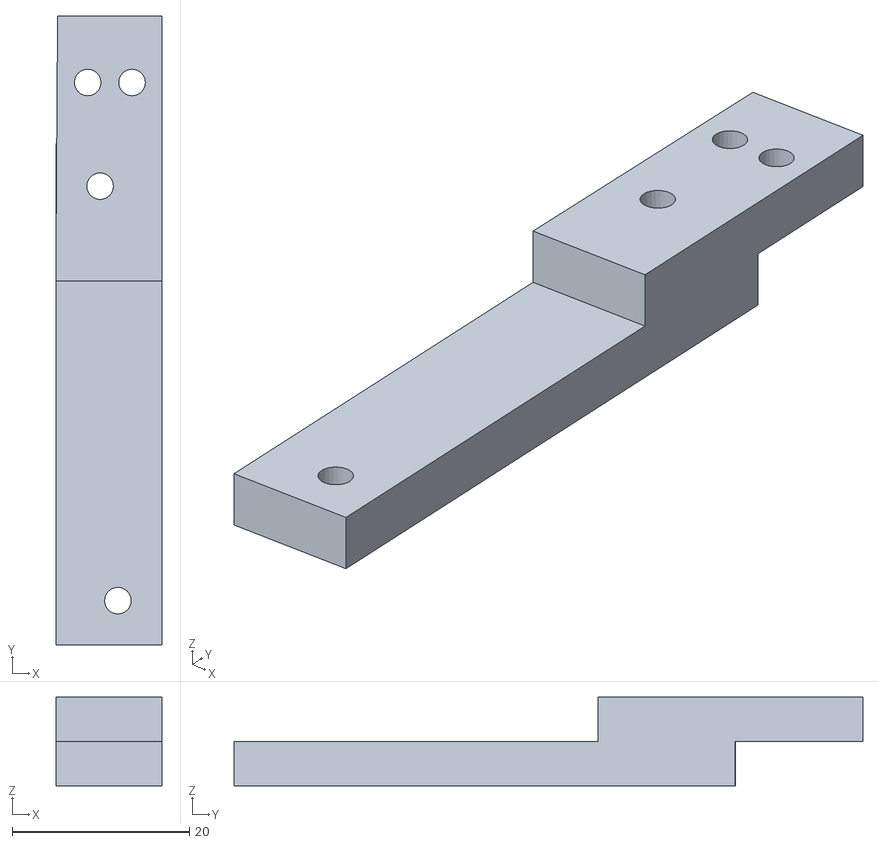
[picture p115: CAD file, 2021-06-17]
Diseño_Mecánico/Archivos_STL/Antebrazo/platina motor 2.stl
12.0 x 70.9 x 10.00
