franciscoarcos19/Proyecto_Protesis/Diseño_Mecánico/Archivos_STL/Gripper_Mano/Pinza media.stl

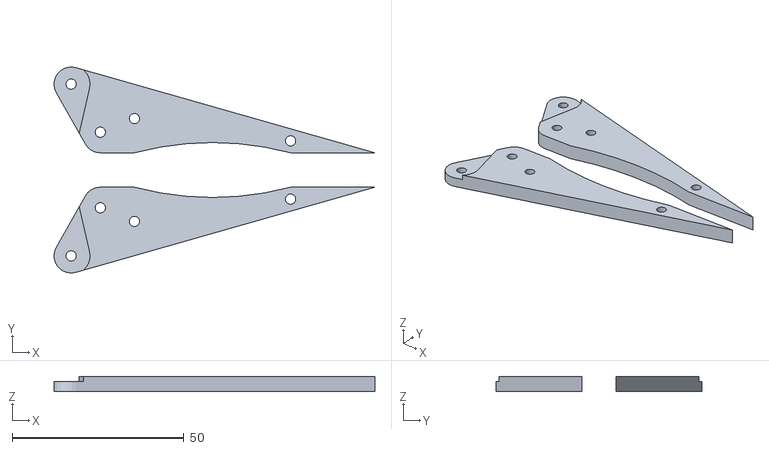
[picture p116: CAD file, 2021-06-17]
Diseño_Mecánico/Archivos_STL/Gripper_Mano/Pinza media.stl
93.5 x 60.0 x 4.50
