franciscoarcos19/Proyecto_Protesis/Diseño_Mecánico/Archivos_STL/Muneca/Tapa3.stl

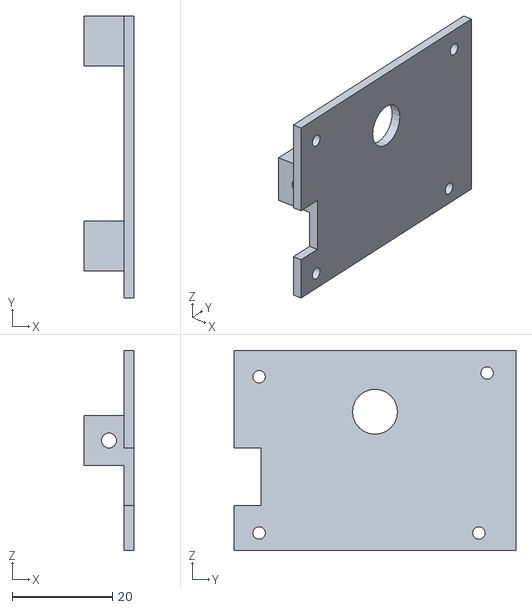
[picture p117: CAD file, 2021-06-17]
Diseño_Mecánico/Archivos_STL/Muneca/Tapa3.stl
10.00 x 56.3 x 40.0
