franciscoarcos19/Proyecto_Protesis/Diseño_Mecánico/Archivos_STL/Antebrazo/RMX7.stl

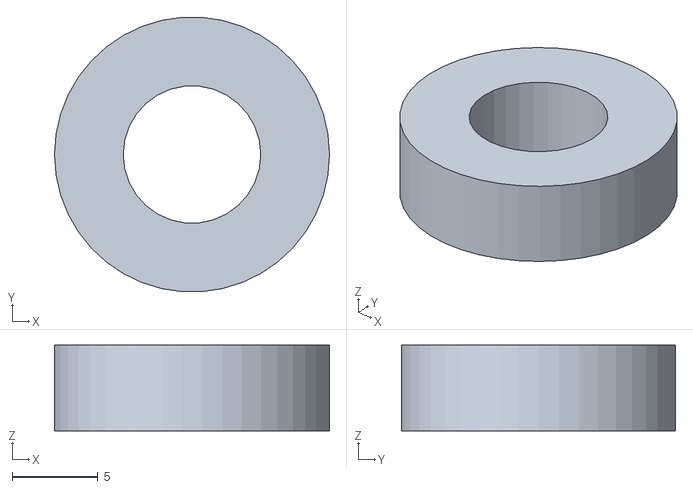
[picture p118: CAD file, 2021-06-17]
Diseño_Mecánico/Archivos_STL/Antebrazo/RMX7.stl
16.0 x 16.0 x 5.00
