franciscoarcos19/Proyecto_Protesis/Diseño_Mecánico/Archivos_STL/Gripper_Mano/Aspa curvaX2.stl

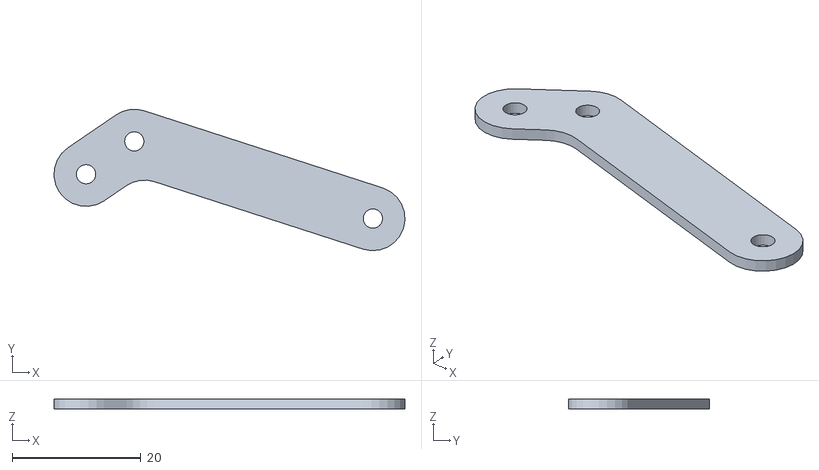
[picture p119: CAD file, 2021-06-17]
Diseño_Mecánico/Archivos_STL/Gripper_Mano/Aspa curvaX2.stl
54.6 x 22.0 x 1.50
