franciscoarcos19/Proyecto_Protesis/Diseño_Mecánico/Archivos_STL/Muneca/Corona.stl

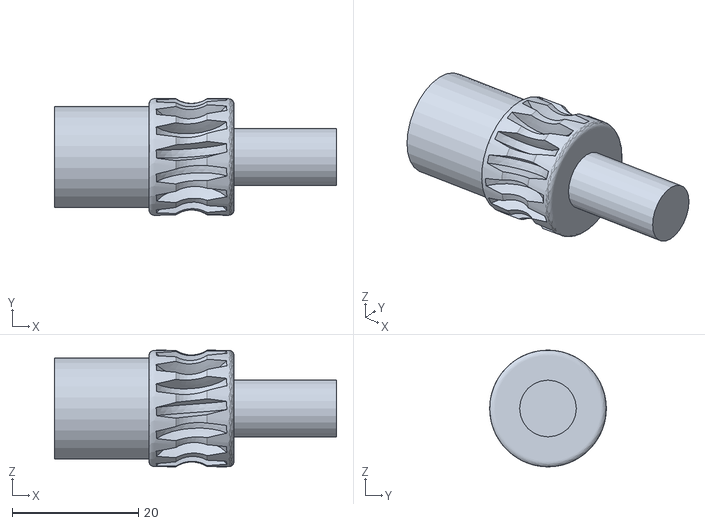
[picture p120: CAD file, 2021-06-17]
Diseño_Mecánico/Archivos_STL/Muneca/Corona.stl
44.7 x 18.5 x 18.5
