franciscoarcos19/Proyecto_Protesis/Diseño_Mecánico/Archivos_STL/Antebrazo/platina de giro.stl

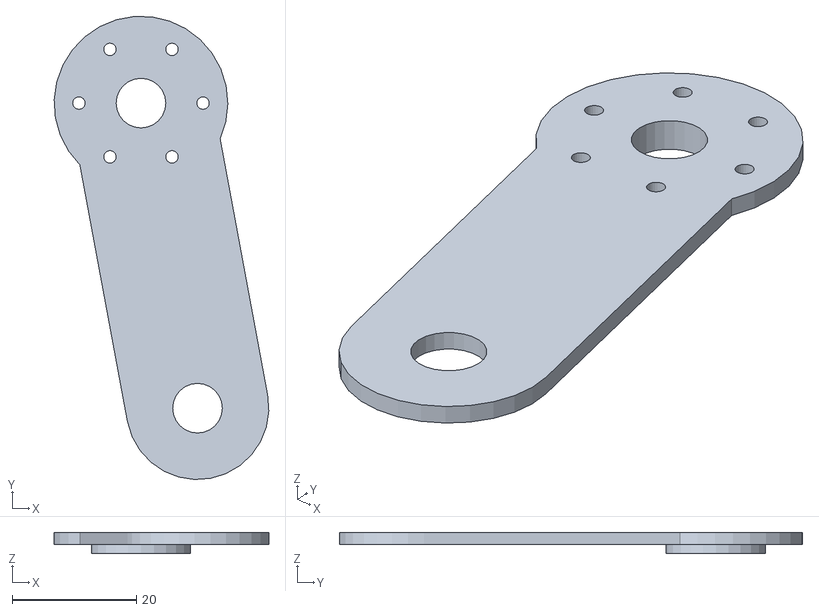
[picture p121: CAD file, 2021-06-17]
Diseño_Mecánico/Archivos_STL/Antebrazo/platina de giro.stl
34.6 x 74.6 x 3.45
