franciscoarcos19/Proyecto_Protesis/Diseño_Mecánico/Archivos_STL/Gripper_Mano/pinza tapa.stl

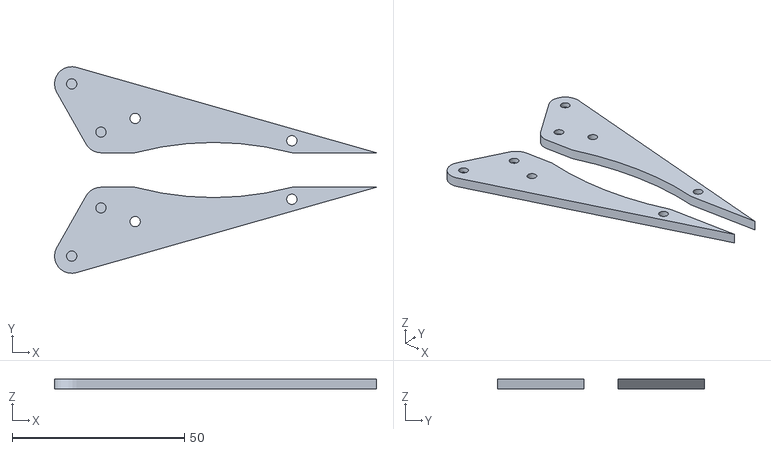
[picture p122: CAD file, 2021-06-17]
Diseño_Mecánico/Archivos_STL/Gripper_Mano/pinza tapa.stl
93.5 x 60.0 x 3.00
