franciscoarcos19/Proyecto_Protesis/Diseño_Mecánico/Archivos_STL/Muneca/Piñon pequeño.stl

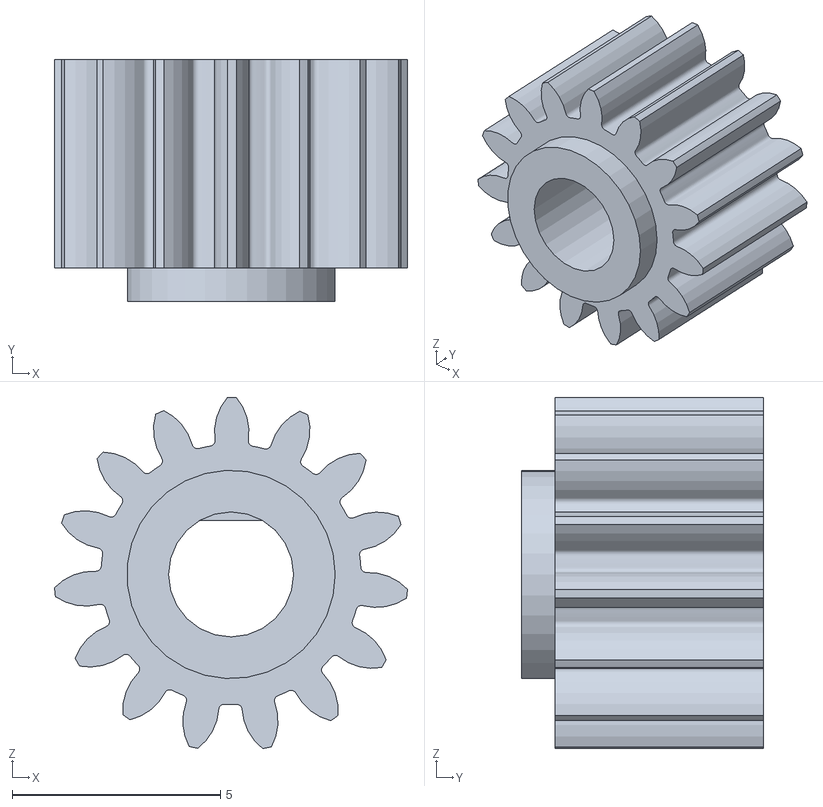
[picture p123: CAD file, 2021-06-17]
Diseño_Mecánico/Archivos_STL/Muneca/Piñon pequeño.stl
8.47 x 5.80 x 8.43
