franciscoarcos19/Proyecto_Protesis/Diseño_Mecánico/Archivos_STL/Antebrazo/Poñon de giro.stl

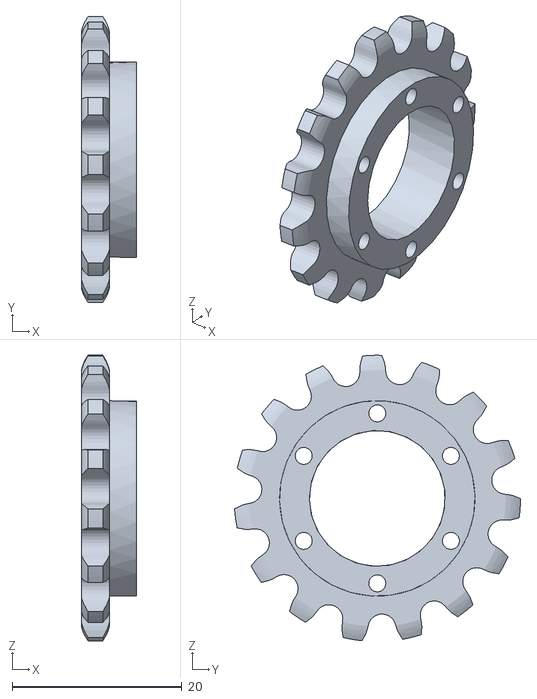
[picture p124: CAD file, 2021-06-17]
Diseño_Mecánico/Archivos_STL/Antebrazo/Poñon de giro.stl
6.50 x 33.7 x 33.6
