franciscoarcos19/Proyecto_Protesis/Diseño_Mecánico/Archivos_STL/Gripper_Mano/Tuerca.stl

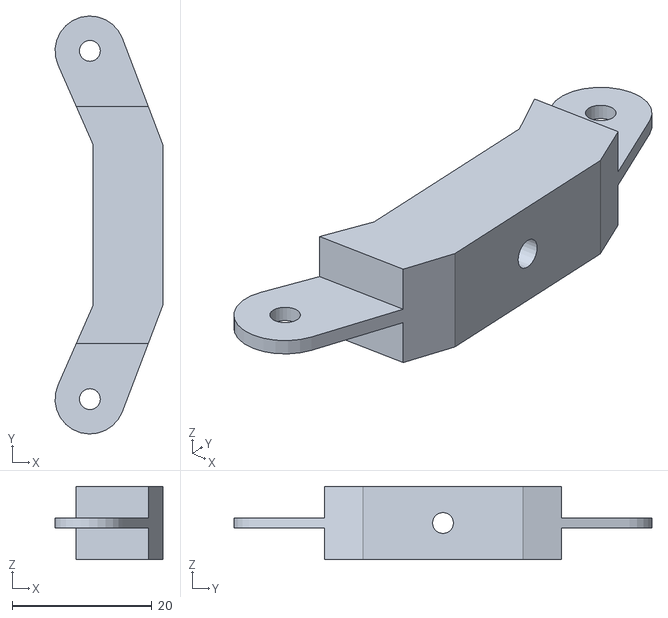
[picture p125: CAD file, 2021-06-17]
Diseño_Mecánico/Archivos_STL/Gripper_Mano/Tuerca.stl
15.5 x 59.9 x 10.5
