franciscoarcos19/Proyecto_Protesis/Diseño_Mecánico/Archivos_STL/Muneca/Tapa2.stl

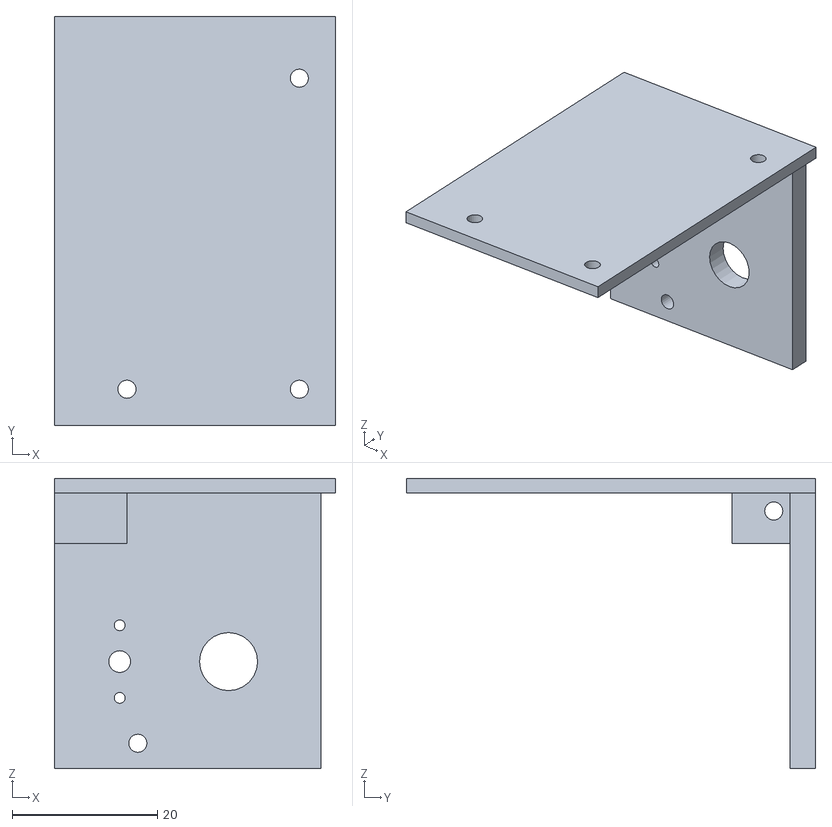
[picture p126: CAD file, 2021-06-17]
Diseño_Mecánico/Archivos_STL/Muneca/Tapa2.stl
38.7 x 56.4 x 40.0
