franciscoarcos19/Proyecto_Protesis/Diseño_Mecánico/Archivos_STL/Antebrazo/Socket.stl

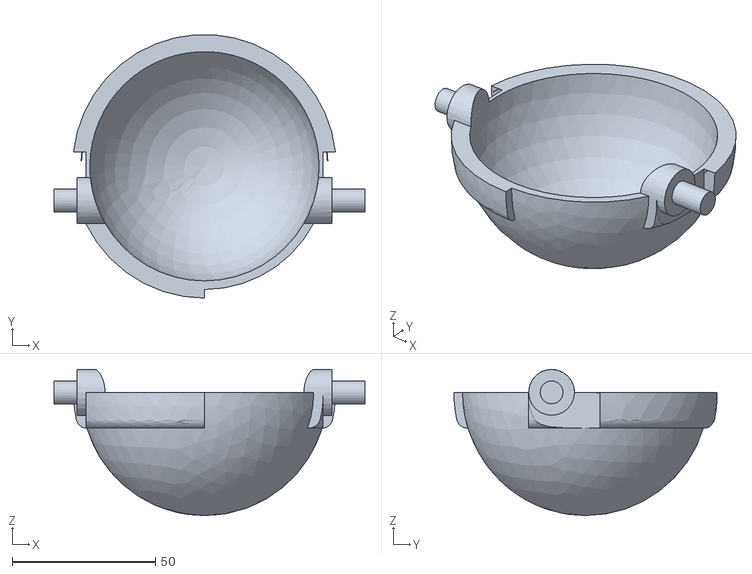
[picture p127: CAD file, 2021-06-17]
Diseño_Mecánico/Archivos_STL/Antebrazo/Socket.stl
108.5 x 91.9 x 51.0
