franciscoarcos19/Proyecto_Protesis/Diseño_Mecánico/Archivos_STL/Muneca/Piñon grande.stl

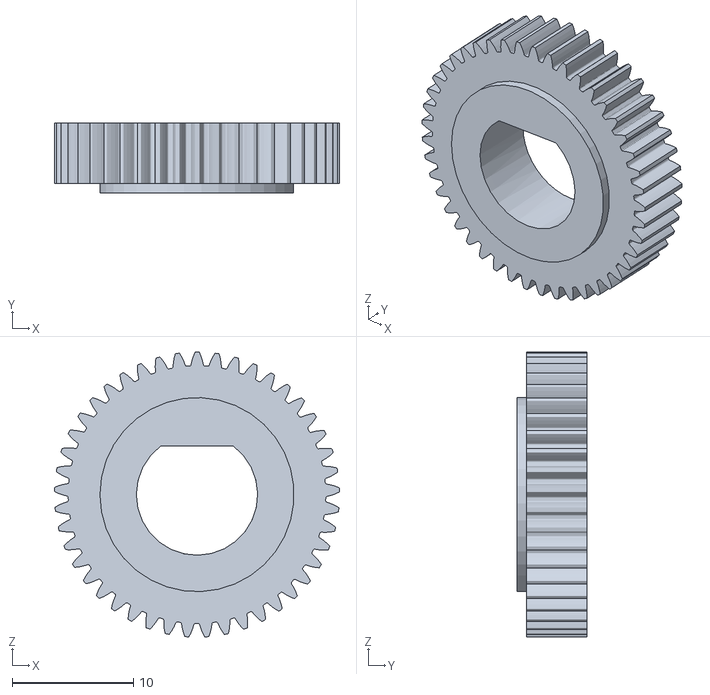
[picture p128: CAD file, 2021-06-17]
Diseño_Mecánico/Archivos_STL/Muneca/Piñon grande.stl
23.5 x 5.80 x 23.5
