franciscoarcos19/Proyecto_Protesis/Diseño_Mecánico/Archivos_STL/Antebrazo/Piñon grandeX2.stl

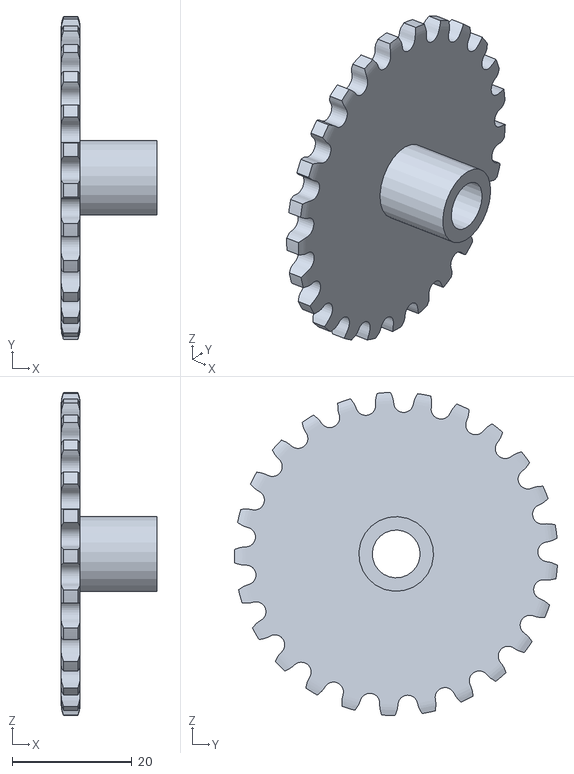
[picture p129: CAD file, 2021-06-17]
Diseño_Mecánico/Archivos_STL/Antebrazo/Piñon grandeX2.stl
16.0 x 54.0 x 54.1
