franciscoarcos19/Proyecto_Protesis/Diseño_Mecánico/Archivos_STL/Gripper_Mano/Superior.stl

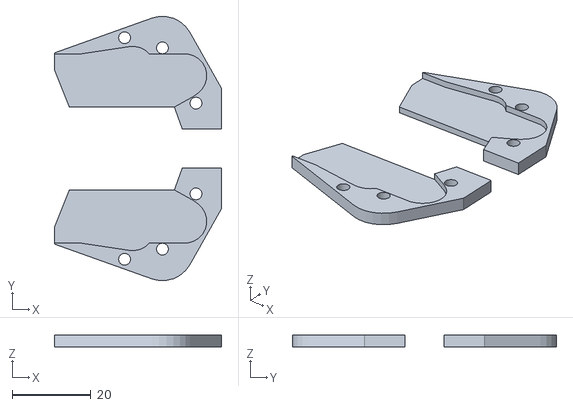
[picture p130: CAD file, 2021-06-17]
Diseño_Mecánico/Archivos_STL/Gripper_Mano/Superior.stl
42.4 x 66.9 x 3.00
