franciscoarcos19/Proyecto_Protesis/Diseño_Mecánico/Archivos_STL/Muneca/Sin fin (5.19°).stl

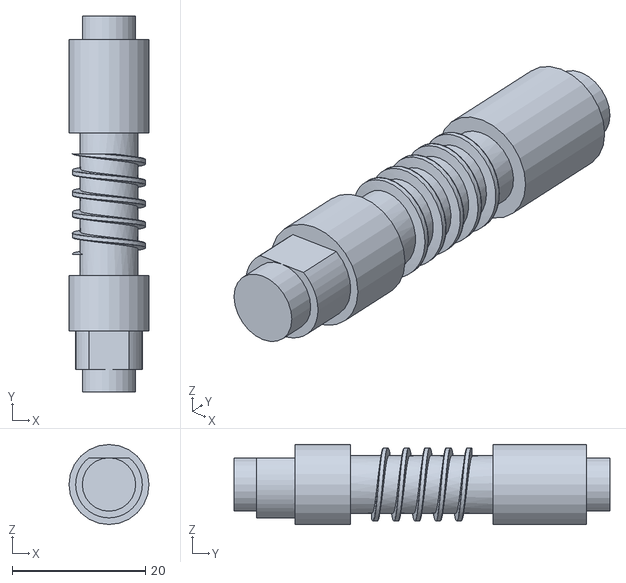
[picture p131: CAD file, 2021-06-17]
Diseño_Mecánico/Archivos_STL/Muneca/Sin fin (5.19°).stl
12.0 x 56.4 x 12.0
