franciscoarcos19/Proyecto_Protesis/Diseño_Mecánico/Archivos_STL/Antebrazo/platina larga 2.stl

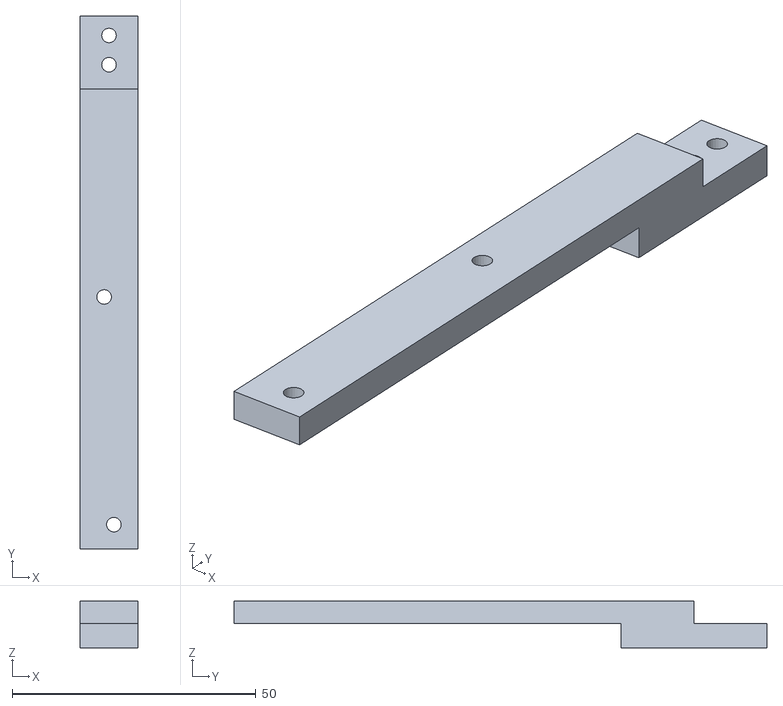
[picture p132: CAD file, 2021-06-17]
Diseño_Mecánico/Archivos_STL/Antebrazo/platina larga 2.stl
12.0 x 109.4 x 9.64
