franciscoarcos19/Proyecto_Protesis/Diseño_Mecánico/Archivos_STL/Gripper_Mano/Aspa rectaX8.stl

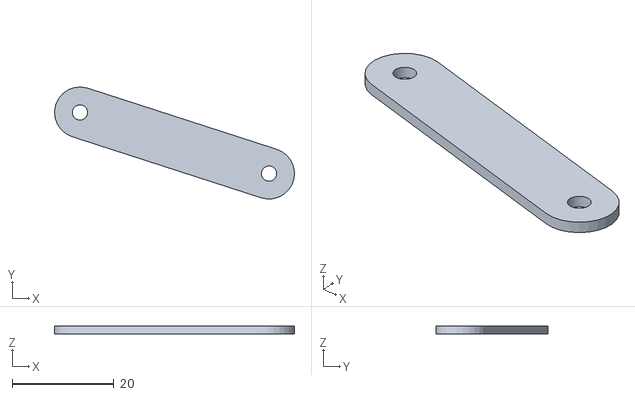
[picture p133: CAD file, 2021-06-17]
Diseño_Mecánico/Archivos_STL/Gripper_Mano/Aspa rectaX8.stl
47.1 x 22.0 x 1.50
