franciscoarcos19/Proyecto_Protesis/Diseño_Mecánico/Archivos_STL/Muneca/Tapa1.stl

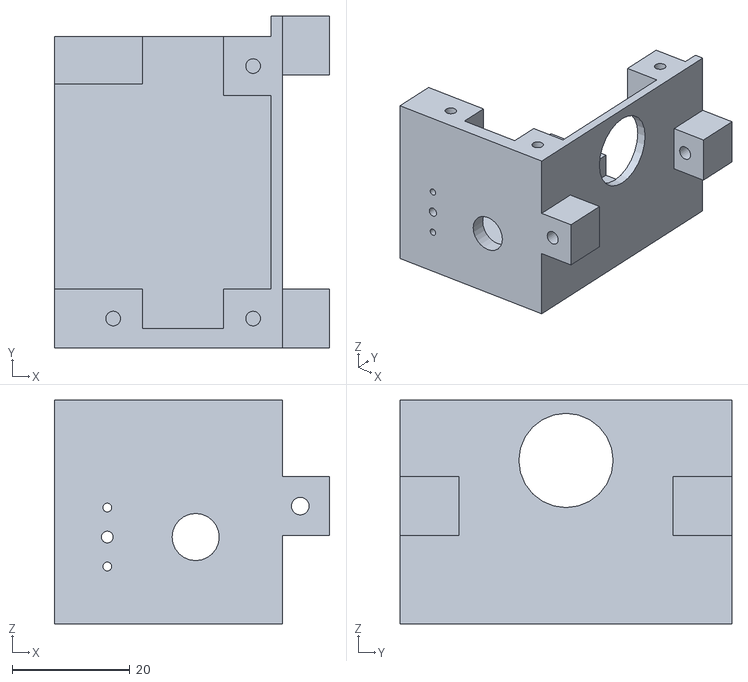
[picture p134: CAD file, 2021-06-17]
Diseño_Mecánico/Archivos_STL/Muneca/Tapa1.stl
46.7 x 56.3 x 38.0
