franciscoarcos19/Proyecto_Protesis/Diseño_Mecánico/Archivos_STL/Antebrazo/platina larga 1.stl

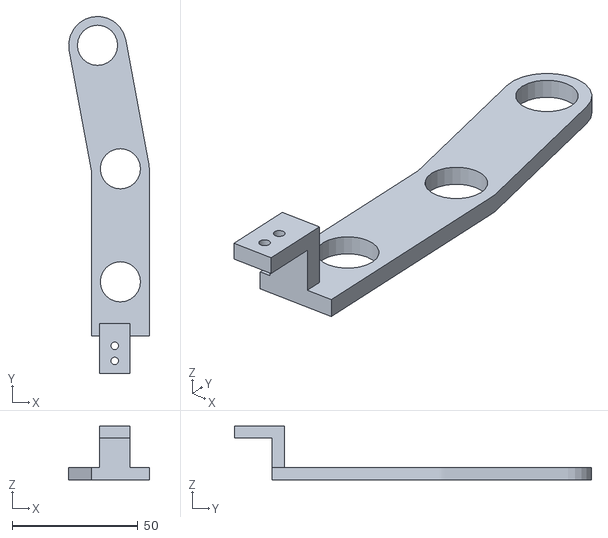
[picture p135: CAD file, 2021-06-17]
Diseño_Mecánico/Archivos_STL/Antebrazo/platina larga 1.stl
32.1 x 142.1 x 21.4
