franciscoarcos19/Proyecto_Protesis/Diseño_Mecánico/Archivos_STL/Antebrazo/Piñon Motor.stl

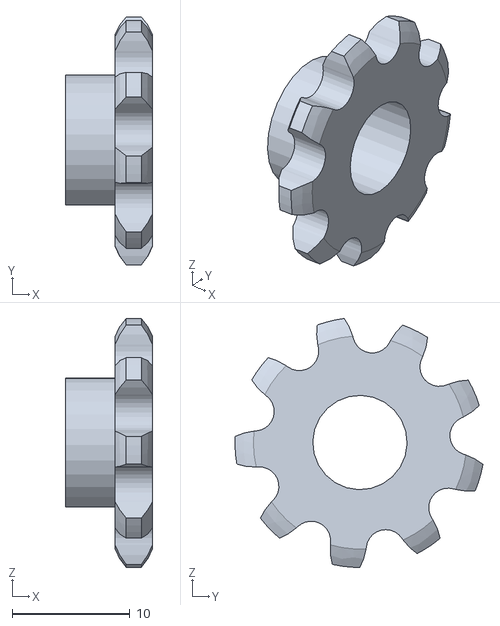
[picture p136: CAD file, 2021-06-17]
Diseño_Mecánico/Archivos_STL/Antebrazo/Piñon Motor.stl
7.38 x 21.0 x 21.1
