franciscoarcos19/Proyecto_Protesis/Diseño_Mecánico/Archivos_STL/Gripper_Mano/Medio.stl

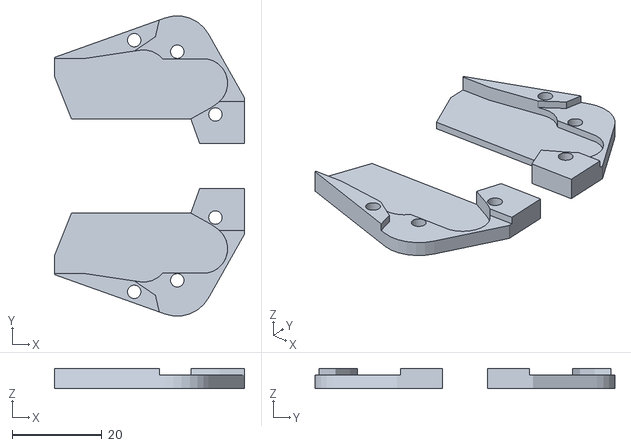
[picture p137: CAD file, 2021-06-17]
Diseño_Mecánico/Archivos_STL/Gripper_Mano/Medio.stl
42.4 x 66.9 x 4.50
