franciscoarcos19/Proyecto_Protesis/Diseño_Mecánico/Archivos_STL/Antebrazo/Piñon pequeño X2.stl

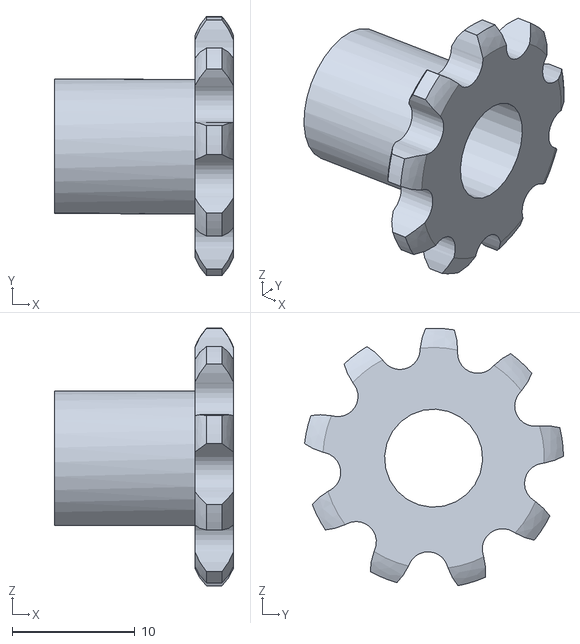
[picture p138: CAD file, 2021-06-17]
Diseño_Mecánico/Archivos_STL/Antebrazo/Piñon pequeño X2.stl
14.6 x 21.1 x 21.0
