franciscoarcos19/Proyecto_Protesis/Diseño_Mecánico/Archivos_STL/Gripper_Mano/UnionX4.stl

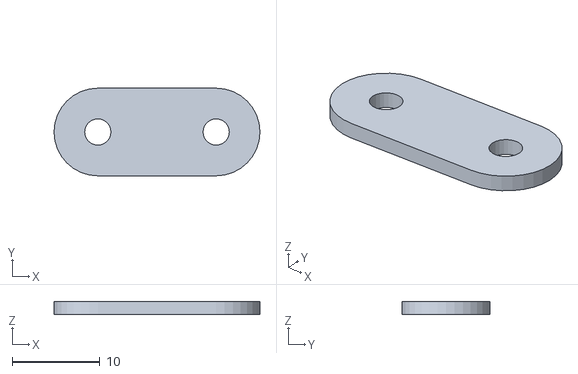
[picture p139: CAD file, 2021-06-17]
Diseño_Mecánico/Archivos_STL/Gripper_Mano/UnionX4.stl
23.5 x 10.00 x 1.50
