franciscoarcos19/Proyecto_Protesis/Diseño_Mecánico/Archivos_STL/Antebrazo/EspaciadorX5.stl

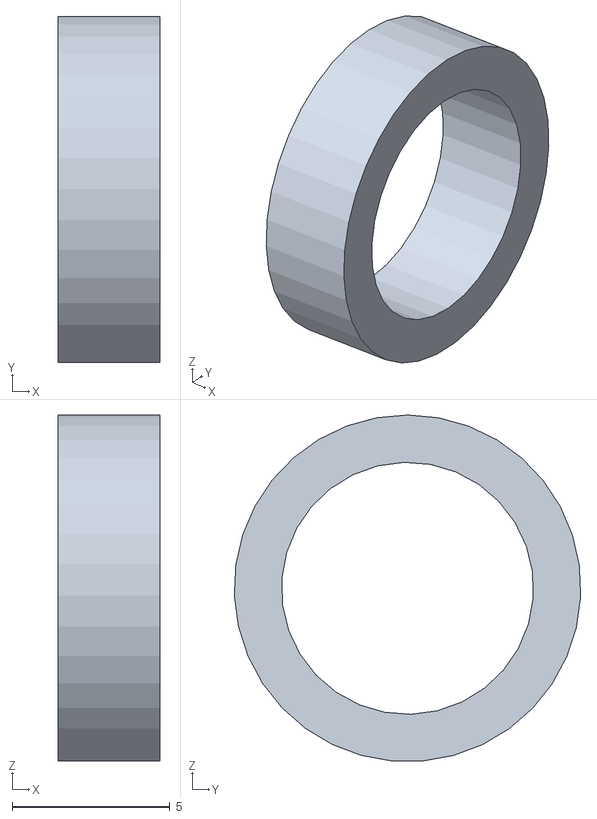
[picture p140: CAD file, 2021-06-17]
Diseño_Mecánico/Archivos_STL/Antebrazo/EspaciadorX5.stl
3.25 x 11.0 x 11.0
