franciscoarcos19/Proyecto_Protesis/Diseño_Mecánico/Archivos_STL/Gripper_Mano/Tapa.stl

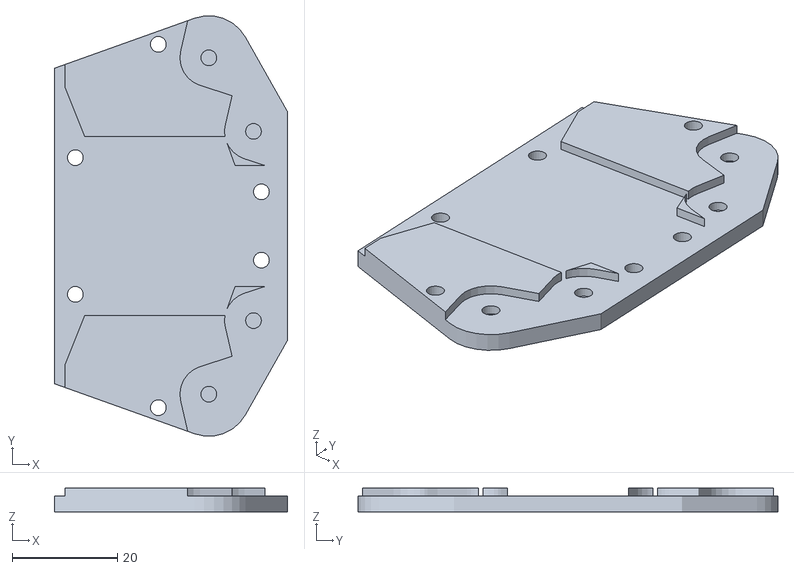
[picture p141: CAD file, 2021-06-17]
Diseño_Mecánico/Archivos_STL/Gripper_Mano/Tapa.stl
44.4 x 79.9 x 4.50
