franciscoarcos19/Proyecto_Protesis/Diseño_Mecánico/Archivos_STL/Antebrazo/platina motor 1.stl

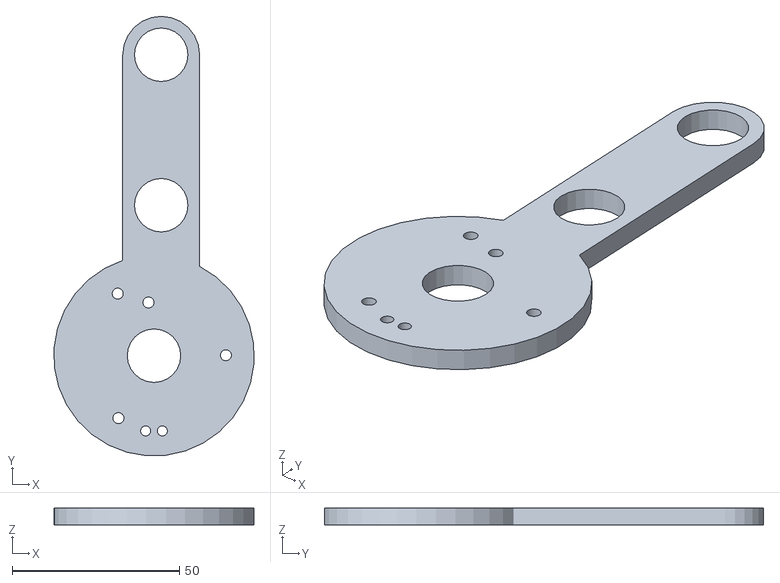
[picture p142: CAD file, 2021-06-17]
Diseño_Mecánico/Archivos_STL/Antebrazo/platina motor 1.stl
59.8 x 131.4 x 5.00
