franciscoarcos19/Proyecto_Protesis/Diseño_Mecánico/Archivos_STL/Gripper_Mano/Bloque centro.stl

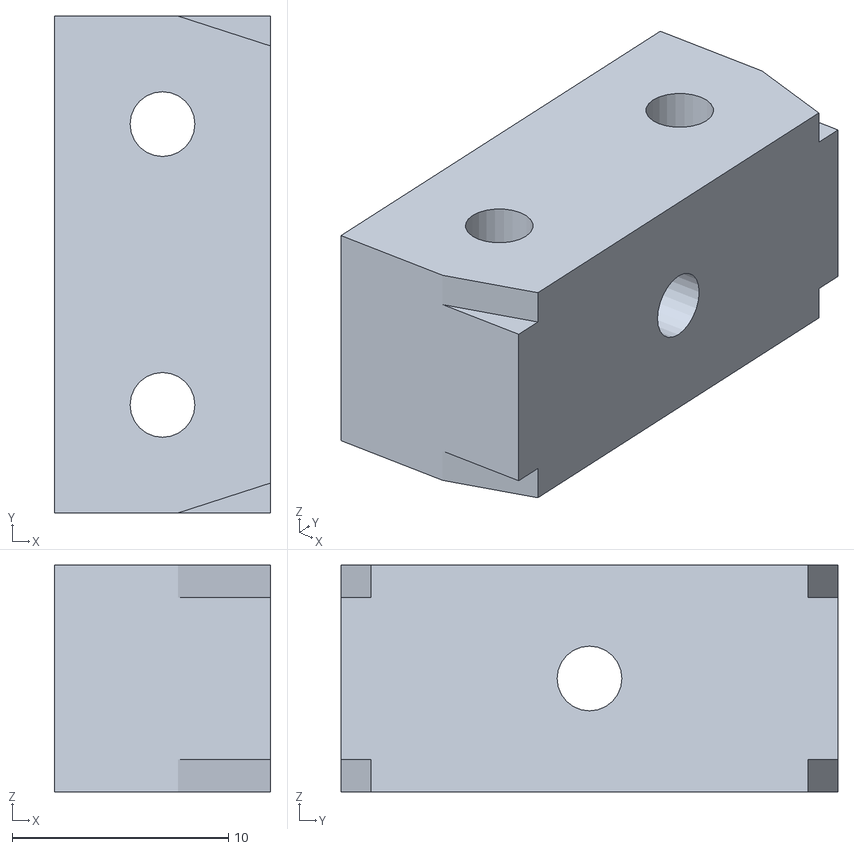
[picture p143: CAD file, 2021-06-17]
Diseño_Mecánico/Archivos_STL/Gripper_Mano/Bloque centro.stl
10.00 x 23.0 x 10.5
