franciscoarcos19/Proyecto_Protesis/Diseño_Mecánico/Archivos_STL/Gripper_Mano/Base.stl

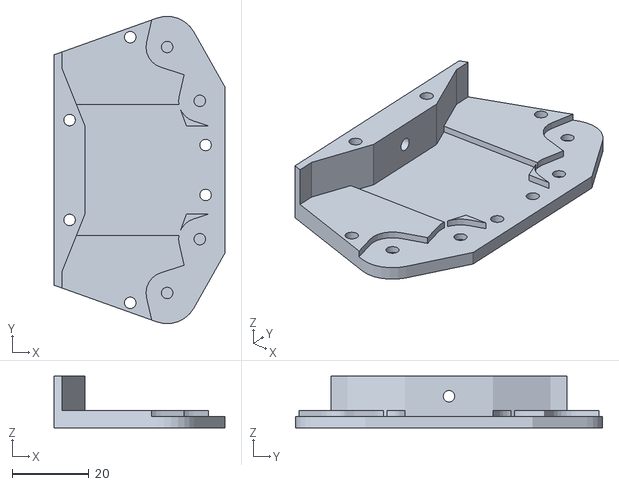
[picture p144: CAD file, 2021-06-17]
Diseño_Mecánico/Archivos_STL/Gripper_Mano/Base.stl
44.4 x 79.9 x 13.5
