franciscoarcos19/Proyecto_Protesis/(list of files, cad)

Other CAD files:
Diseño_Mecánico/Archivos_STL/Gripper_Mano/pinza superior.stl
Diseño_Mecánico/Archivos_STL/Gripper_Mano/Pinza base.stl
