franciscoarcos19/Proyecto_Protesis/Control_Motores/Control_de_Motores_BLDC/Prueba2_funcional_de_motores/Readme.docx

Se debe comprar un regulador de voltaje que tenga capacidad de entregar más corriente, con el que se está trabajando actualmen es el LM317

Hay una diferencia entre las ondas generadas con python y con matlab
