franciscoarcos19/Proyecto_Protesis/Control_Motores/Control_de_Motores_BLDC/Prueba2_funcional_de_motores/posicion_motor.pptx

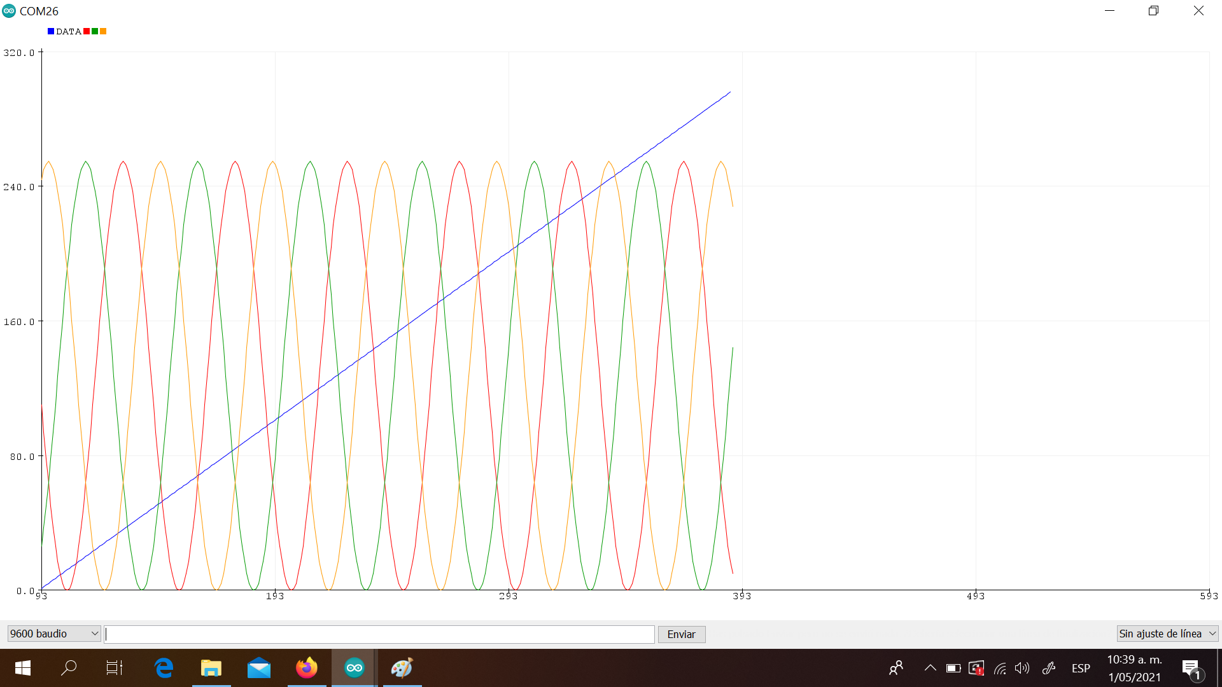
[picture p145: figure]

Divisor = 1

## Slide 2

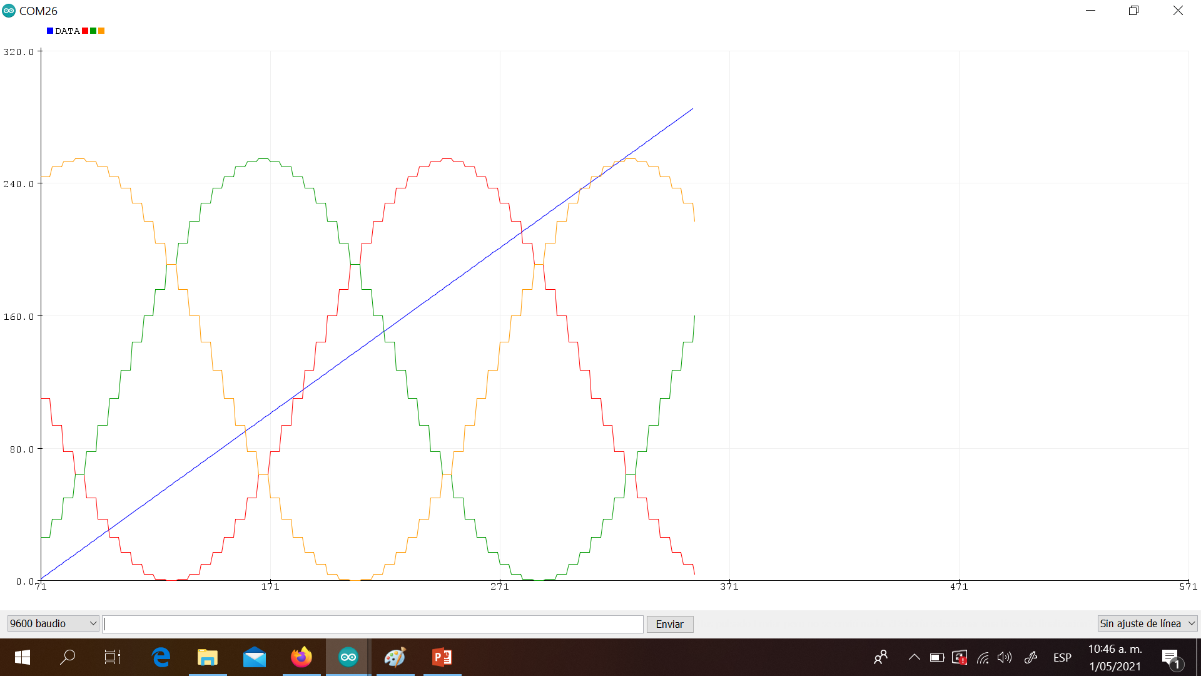
[picture p146: figure]

Divisor = 5
